er-shubhendu-ee/cryonano-nano-stage/cryonano-nano-stage/outputs/bom/Proposed major components.xlsx

Reference | Qty | Value | Order No. | Indicative Unit Price @10 per lot | Description | Datasheet
PS1 | 1 | B2415S-1WR3 | B2415S-1WR3 | 110 | 1W, constant voltage input, isolated unregulated single output DC-DC power module, efficiency up to 85% | https://www.mornsun-power.com/public/uploads/pdf/B_S-1WR3.pdf
PS2 | 1 | B2405S-1WR3 | B2405S-1WR3 | 75 | 1W, constant voltage input, isolated unregulated single output DC-DC power module, efficiency up to 85% | https://www.mornsun-power.com/public/uploads/pdf/B_S-1WR3.pdf
U1 | 1 | AD7124-8BCPZ-RL7 | AD7124-8BCPZ-RL7 | 1230 | 8-Channel, Low Noise, Low Power, 24-Bit, Sigma-Delta ADC with PGA and Reference | https://www.analog.com/AD7124-8/datasheet
U3 | 1 | 1ED3141MU12FXUMA1 | 1ED3141MU12FXUMA1 | 130 | Galvanically Isolated Gate Drivers | https://www.infineon.com/assets/row/public/documents/24/49/infineon-1ed314xmu12f1ed314xmc12h-datasheet-en.pdf
U4 | 1 | AP7363-33D-13 | AP7363-33D-13 | 27 | LDO Voltage Regulators 1.5A Fast Transient Ultra-LDO Linear Reg | https://www.diodes.com/assets/Datasheets/AP7363.pdf
U5 | 1 | STM32L412CxTx | STM32L412C8T6 | 272 | Arm Cortex-M4 32-bit MCU+FPU, 100DMIPS, up to 128KB flash, 40KB SRAM, analog, USB | https://www.st.com/resource/en/datasheet/stm32l412c8.pdf
