er-shubhendu-ee/cryonano-nano-stage/cryonano-nano-stage/outputs/schematics/cryonano-nano-stage.pdf

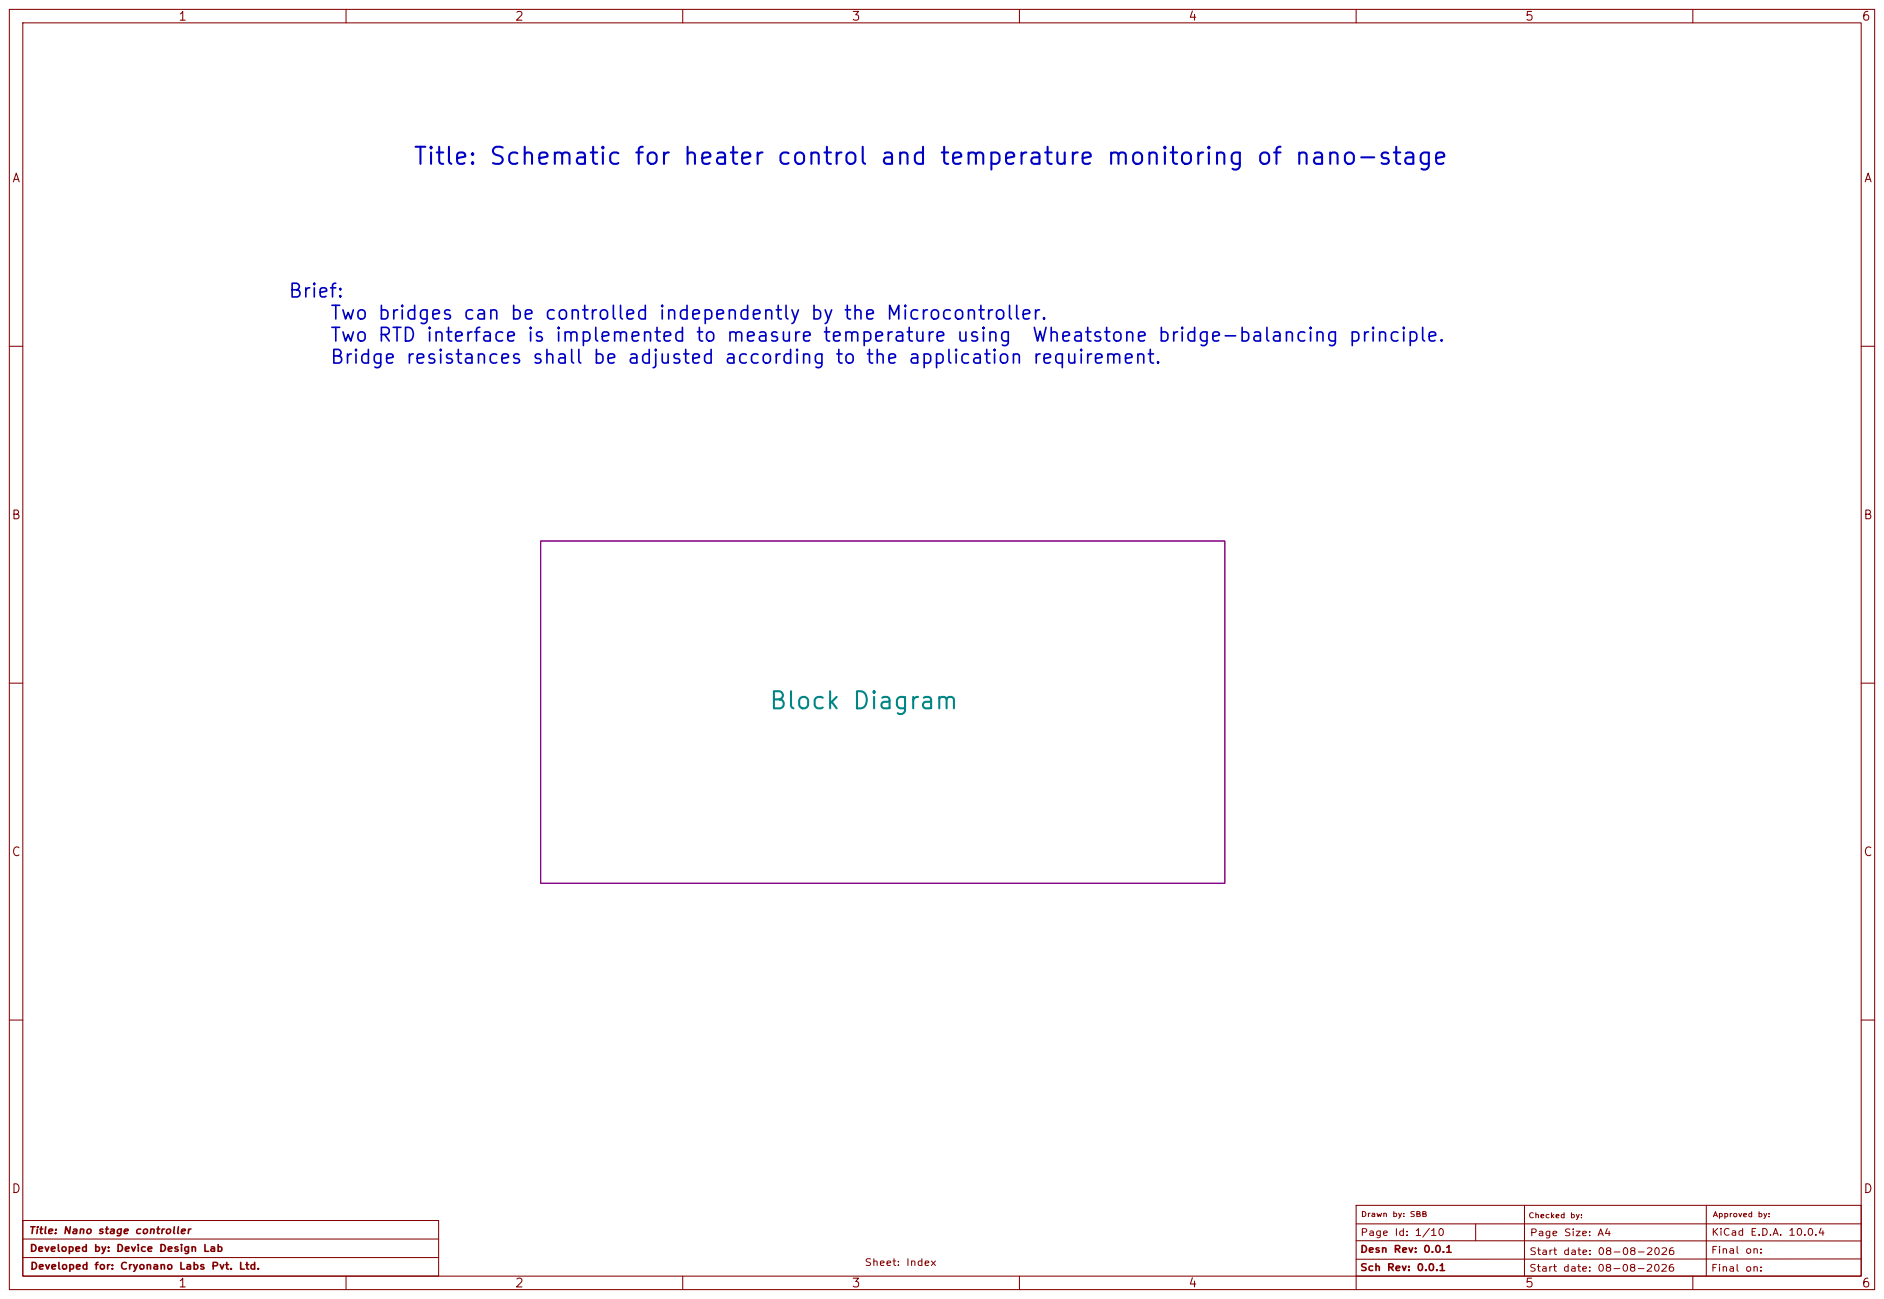
[picture p1: page 1]

Title: Schematic for heater control and temperature monitoring of nano-stage

Brief:
Two bridges can be controlled independently by the Microcontroller.
Two RTD interface is implemented to measure temperature using Wheatstone bridge-balancing principle.
Bridge resistances shall be adjusted according to the application requirement.

Drawn by: SBB Page Id: 1/10
Approved by: KiCad E.D.A. 10.0.4 Desn Rev: 0.0.1

Sch Rev: 0.0.1

Start date: 08-08-2026

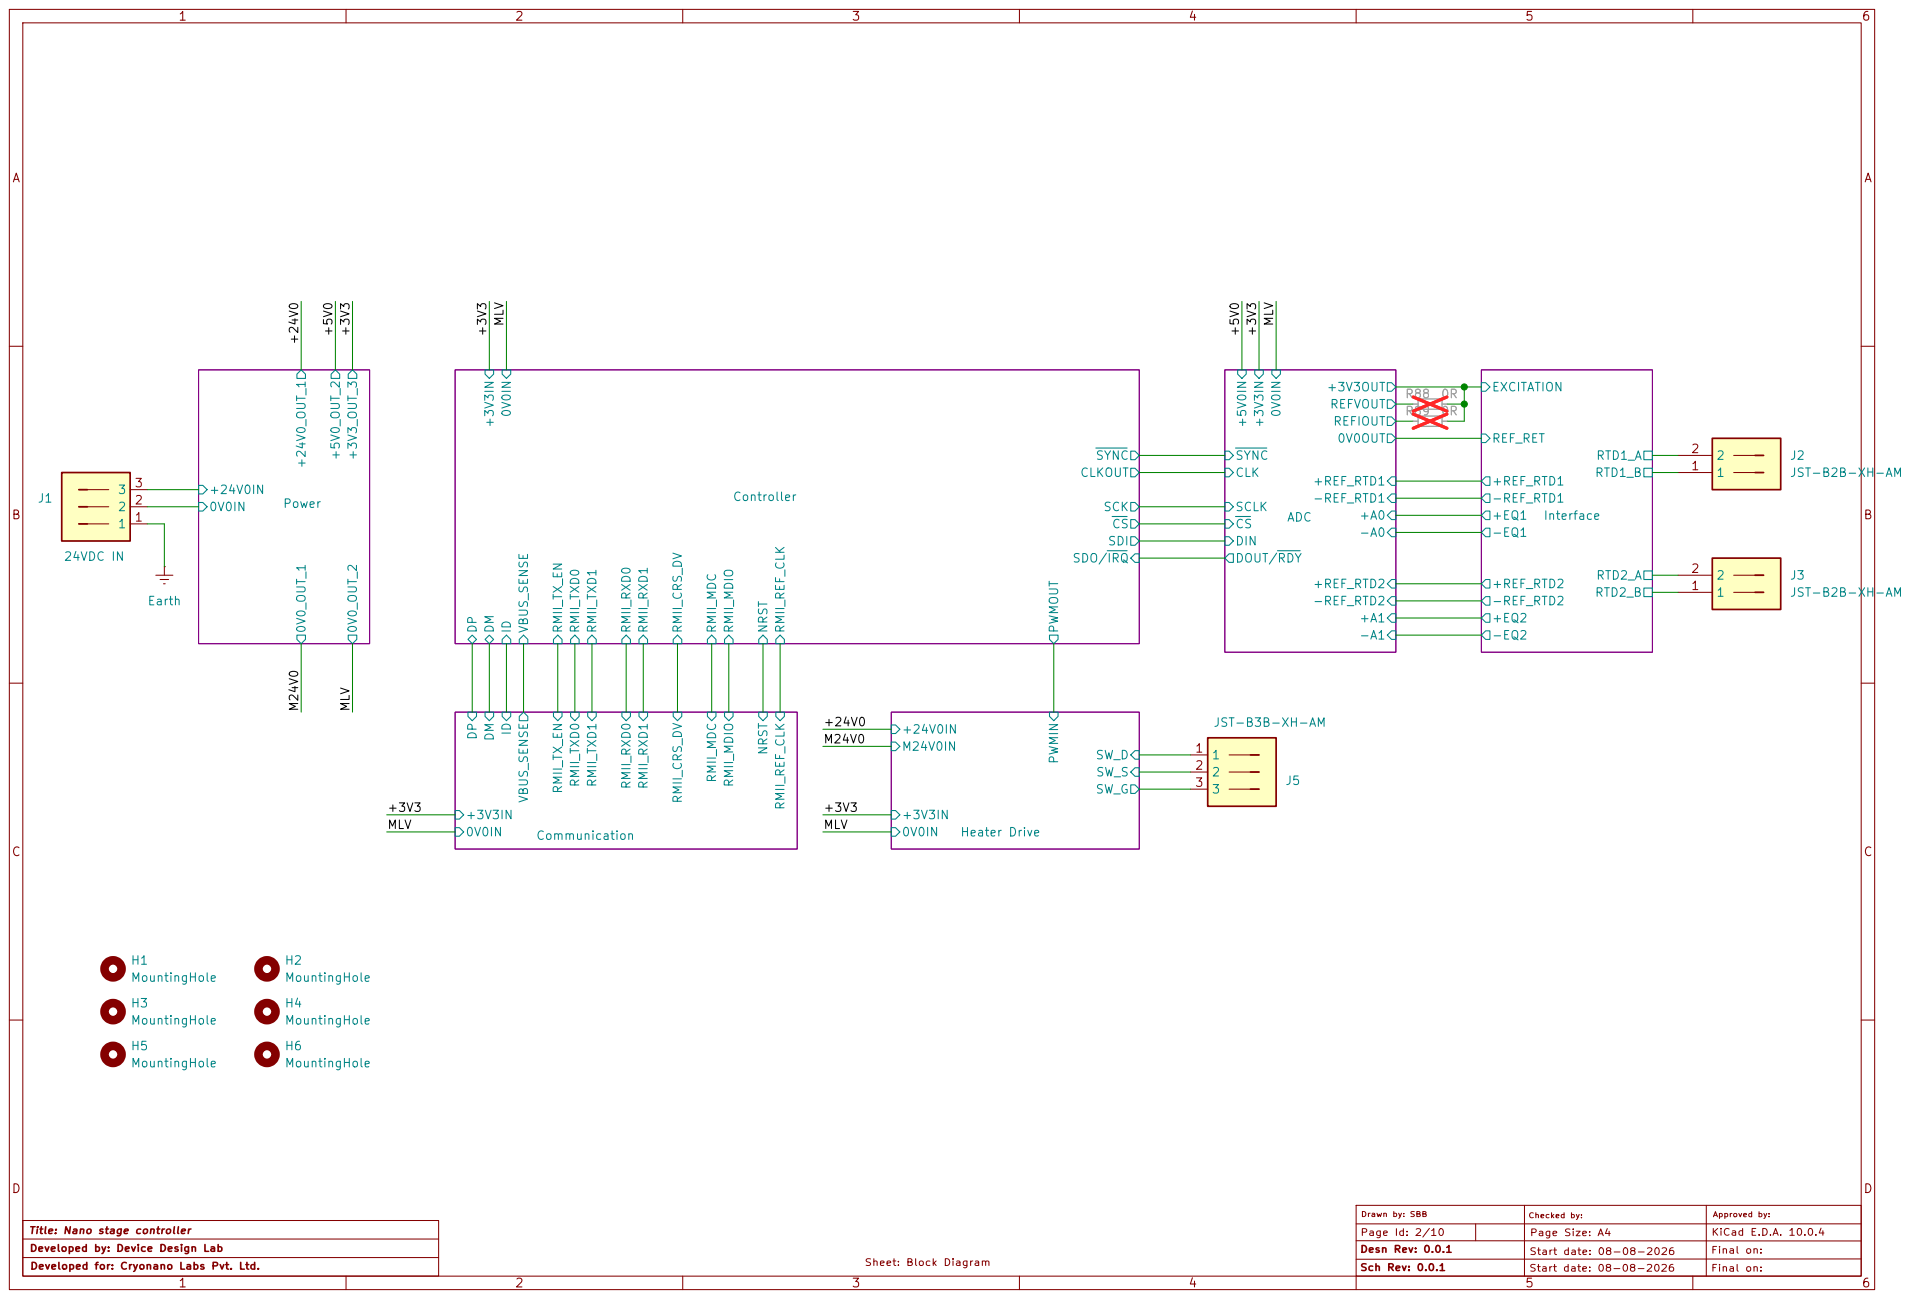
[picture p2: page 2]

Drawn by: SBB Page Id: 2/10
Approved by: KiCad E.D.A. 10.0.4 Desn Rev: 0.0.1

Start date: 08-08-2026 Sheet: Block Diagram

Final on:

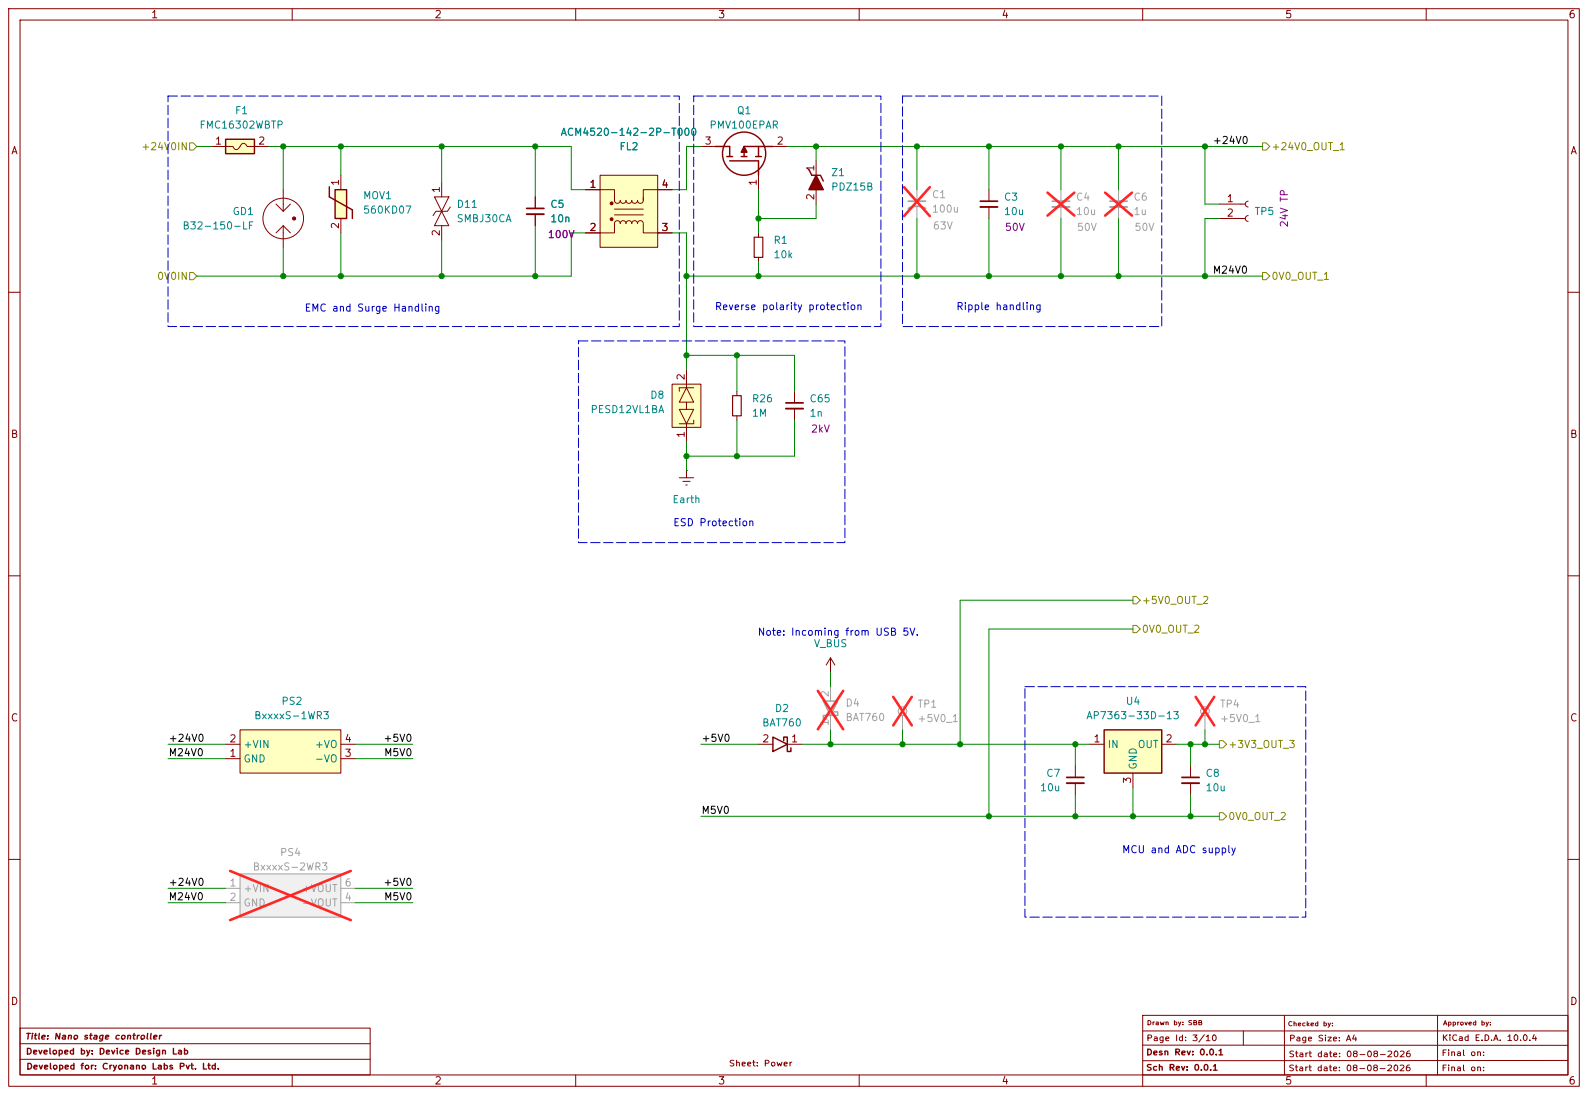
[picture p3: page 3]

Checked by: Developed for: Cryonano Labs Pvt. Ltd.

Drawn by: SBB Page Id: 3/10
Approved by: KiCad E.D.A. 10.0.4 Desn Rev: 0.0.1

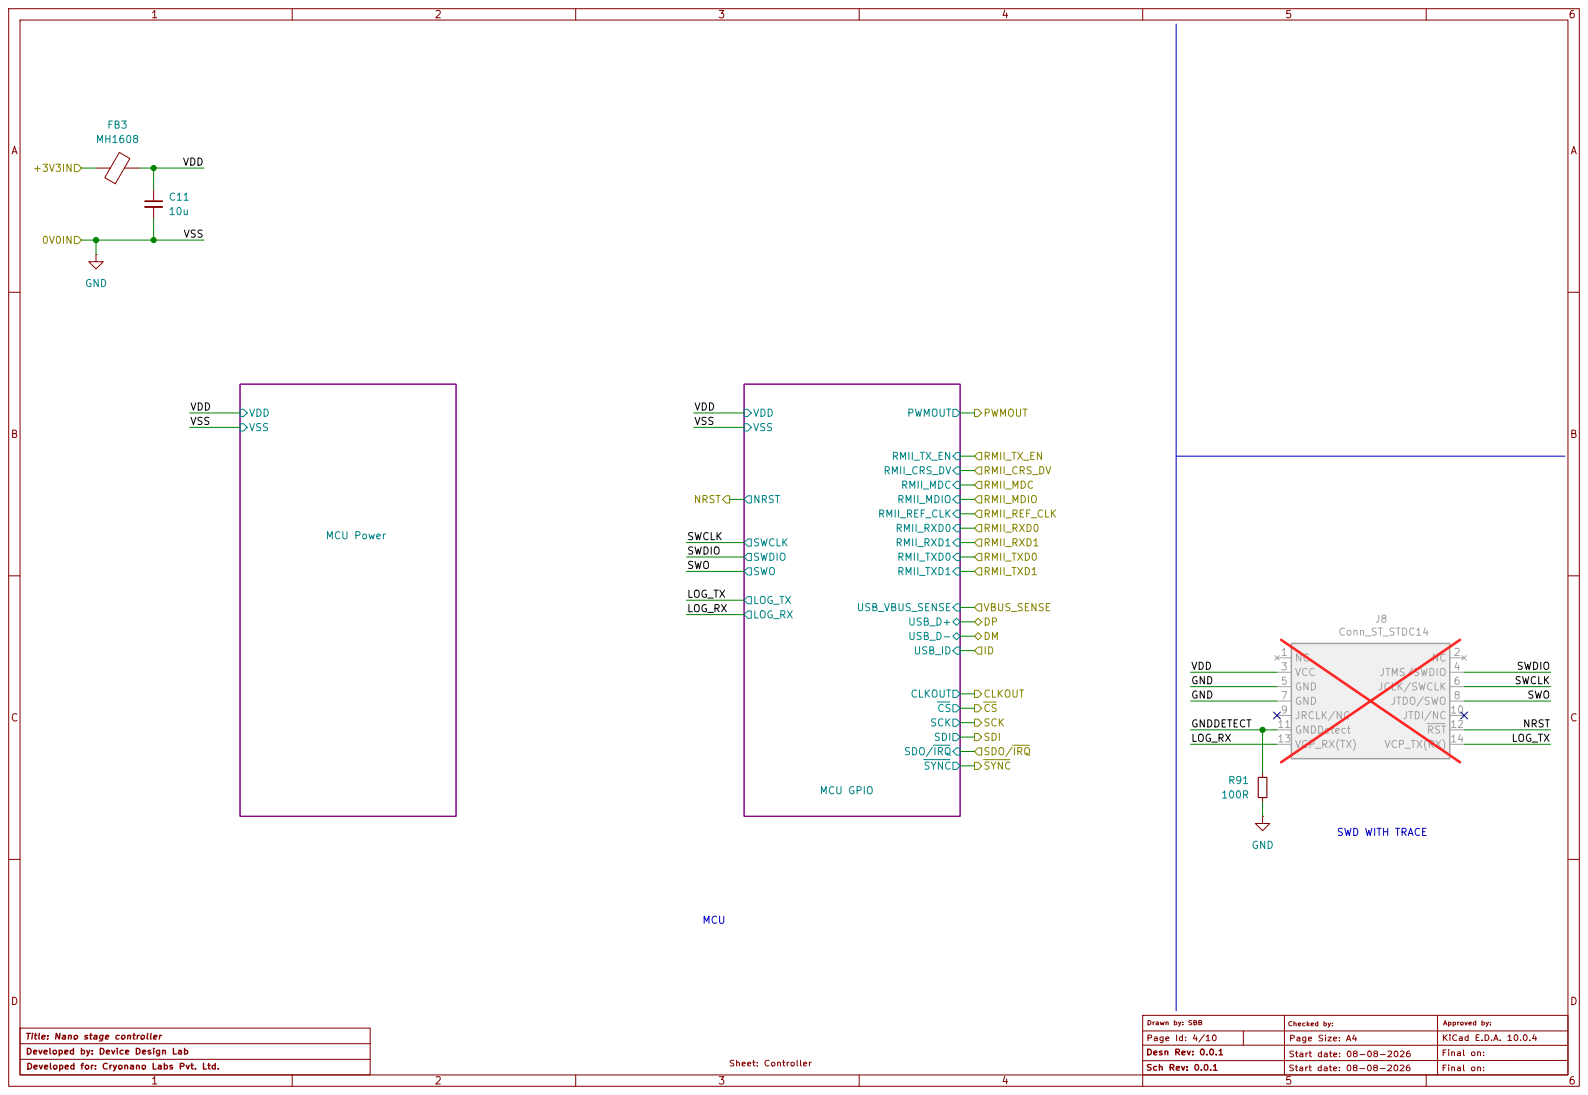
[picture p4: page 4]

Checked by: Developed for: Cryonano Labs Pvt. Ltd.

Drawn by: SBB Page Id: 4/10
Approved by: KiCad E.D.A. 10.0.4 Desn Rev: 0.0.1

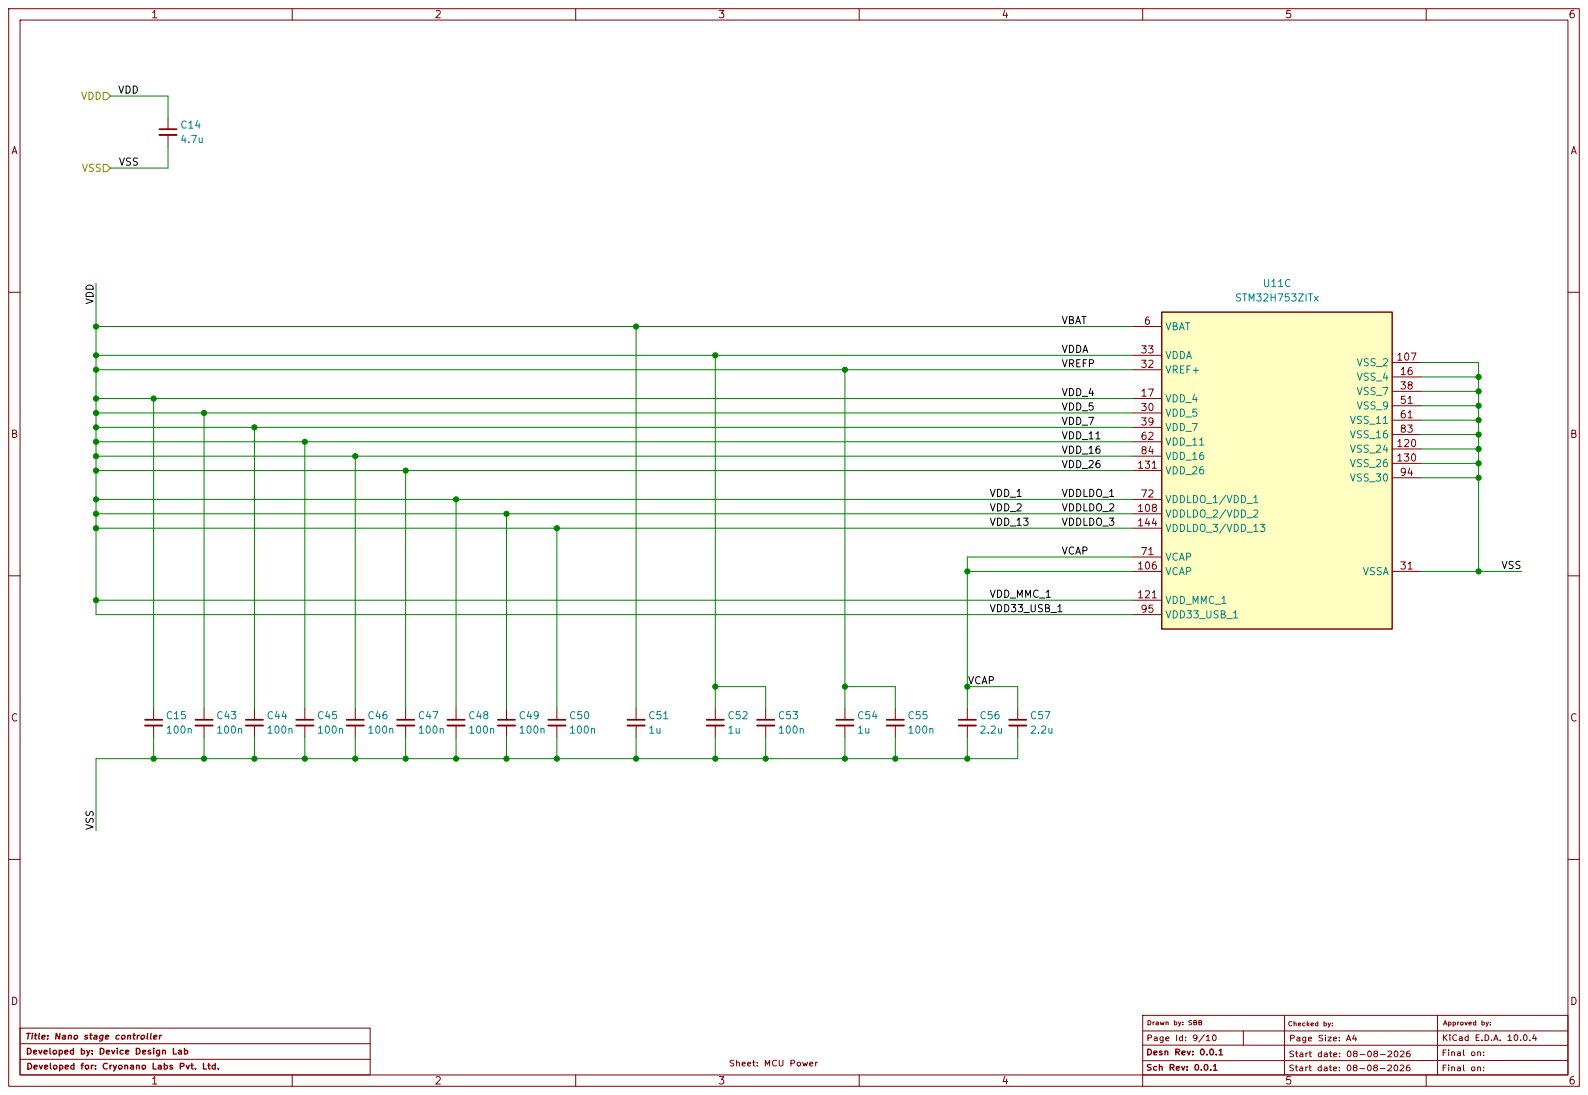
[picture p5: page 5]

VSS VDD VSS | VDD_4 | VDD_4 17

VDD_11 | STM32H753ZITx C54 VDD_11 62

VDD_5 | VDD_5 30
VDD_7 | VDD_7 39

VDD_16 | VDD_16 84
VDD_26 | VDD_26 131

VDD_1 VDDLDO_1 | VDDLDO_1/VDD_1 72
VDD_2 VDDLDO_2 | VDDLDO_2/VDD_2 108
VDD_13 VDDLDO_3

VCAP | VCAP 71

Checked by: Developed for: Cryonano Labs Pvt. Ltd.

Drawn by: SBB Page Id: 9/10
Approved by: KiCad E.D.A. 10.0.4 Desn Rev: 0.0.1

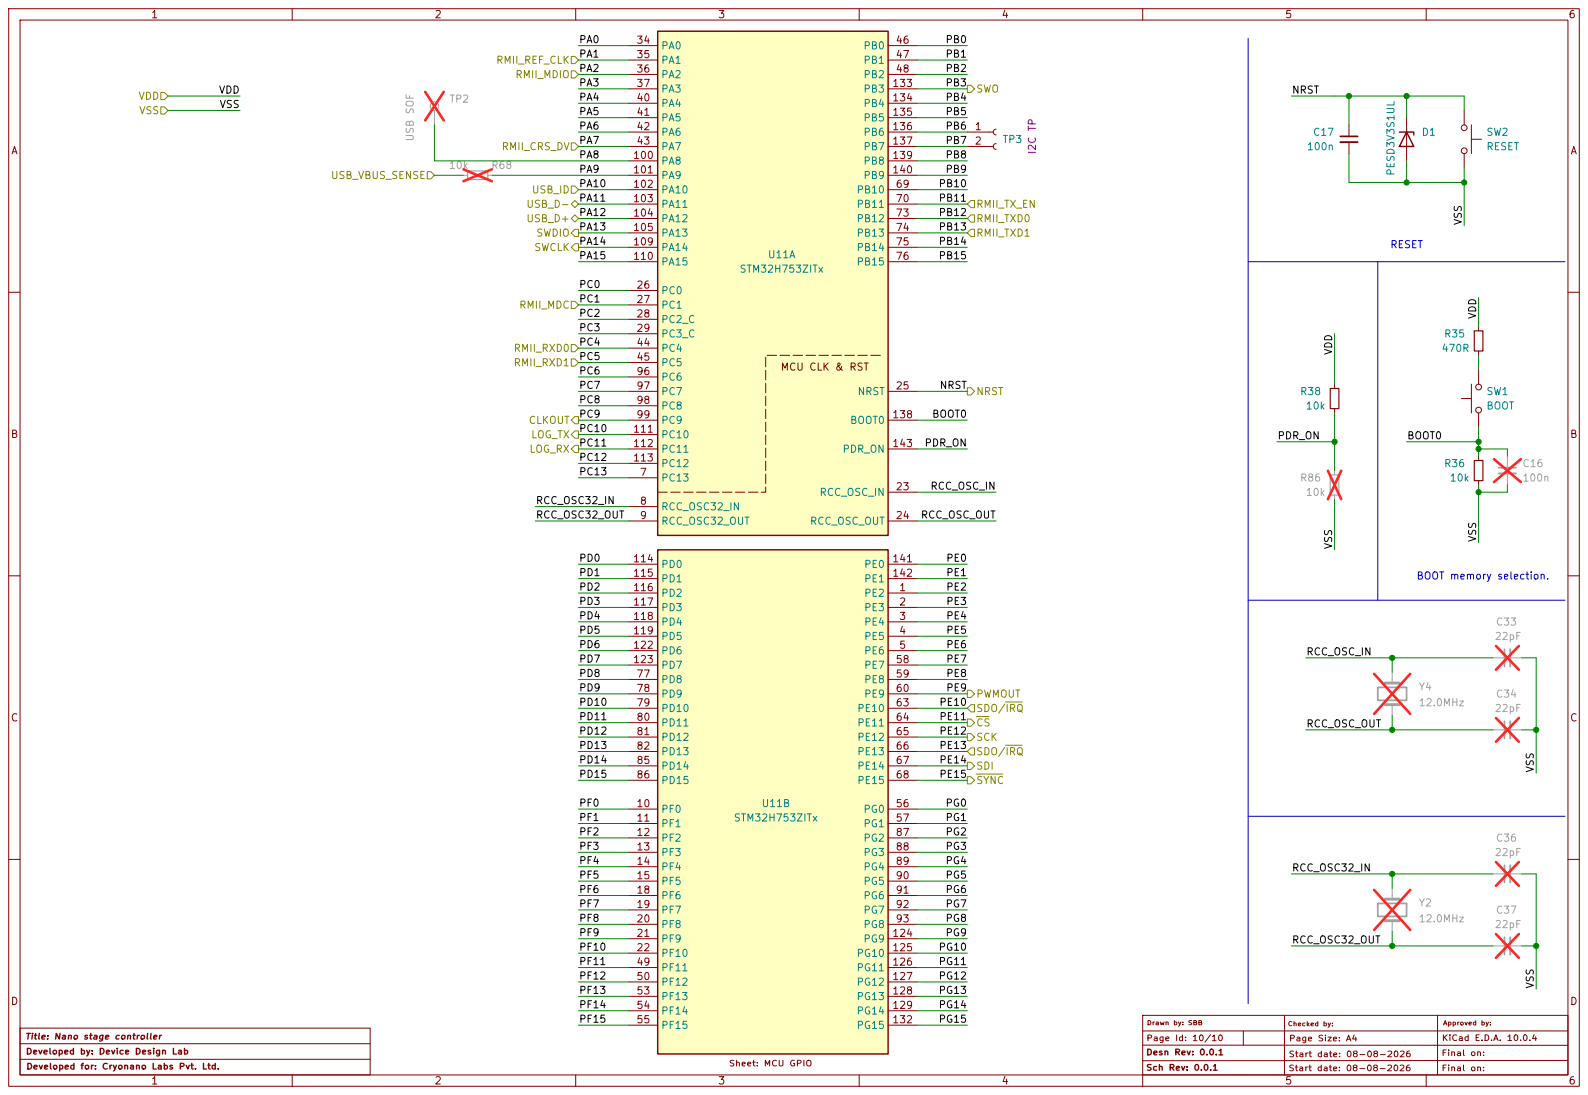
[picture p6: page 6]

Checked by: Developed for: Cryonano Labs Pvt. Ltd.

Drawn by: SBB Page Id: 10/10
Approved by: KiCad E.D.A. 10.0.4 Desn Rev: 0.0.1

Start date: 08-08-2026 Sheet: MCU GPIO

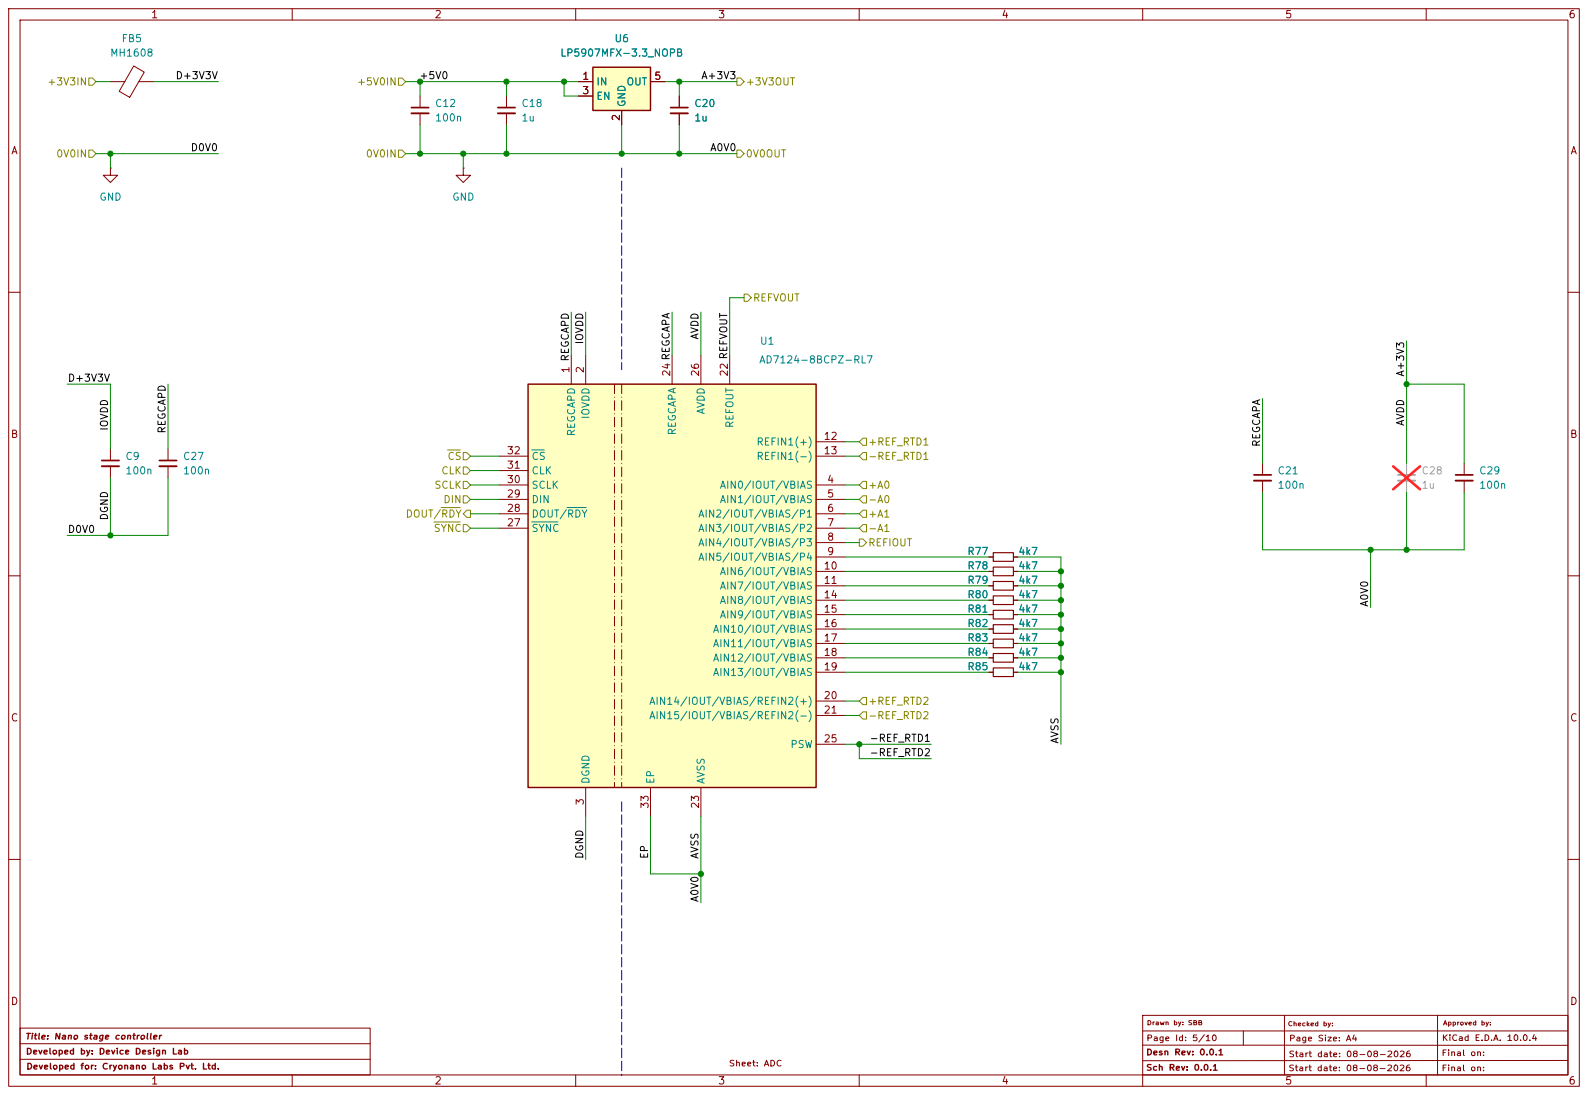
[picture p7: page 7]

Checked by: Developed for: Cryonano Labs Pvt. Ltd.

Drawn by: SBB Page Id: 5/10
Approved by: KiCad E.D.A. 10.0.4 Desn Rev: 0.0.1

Start date: 08-08-2026 Sheet: ADC

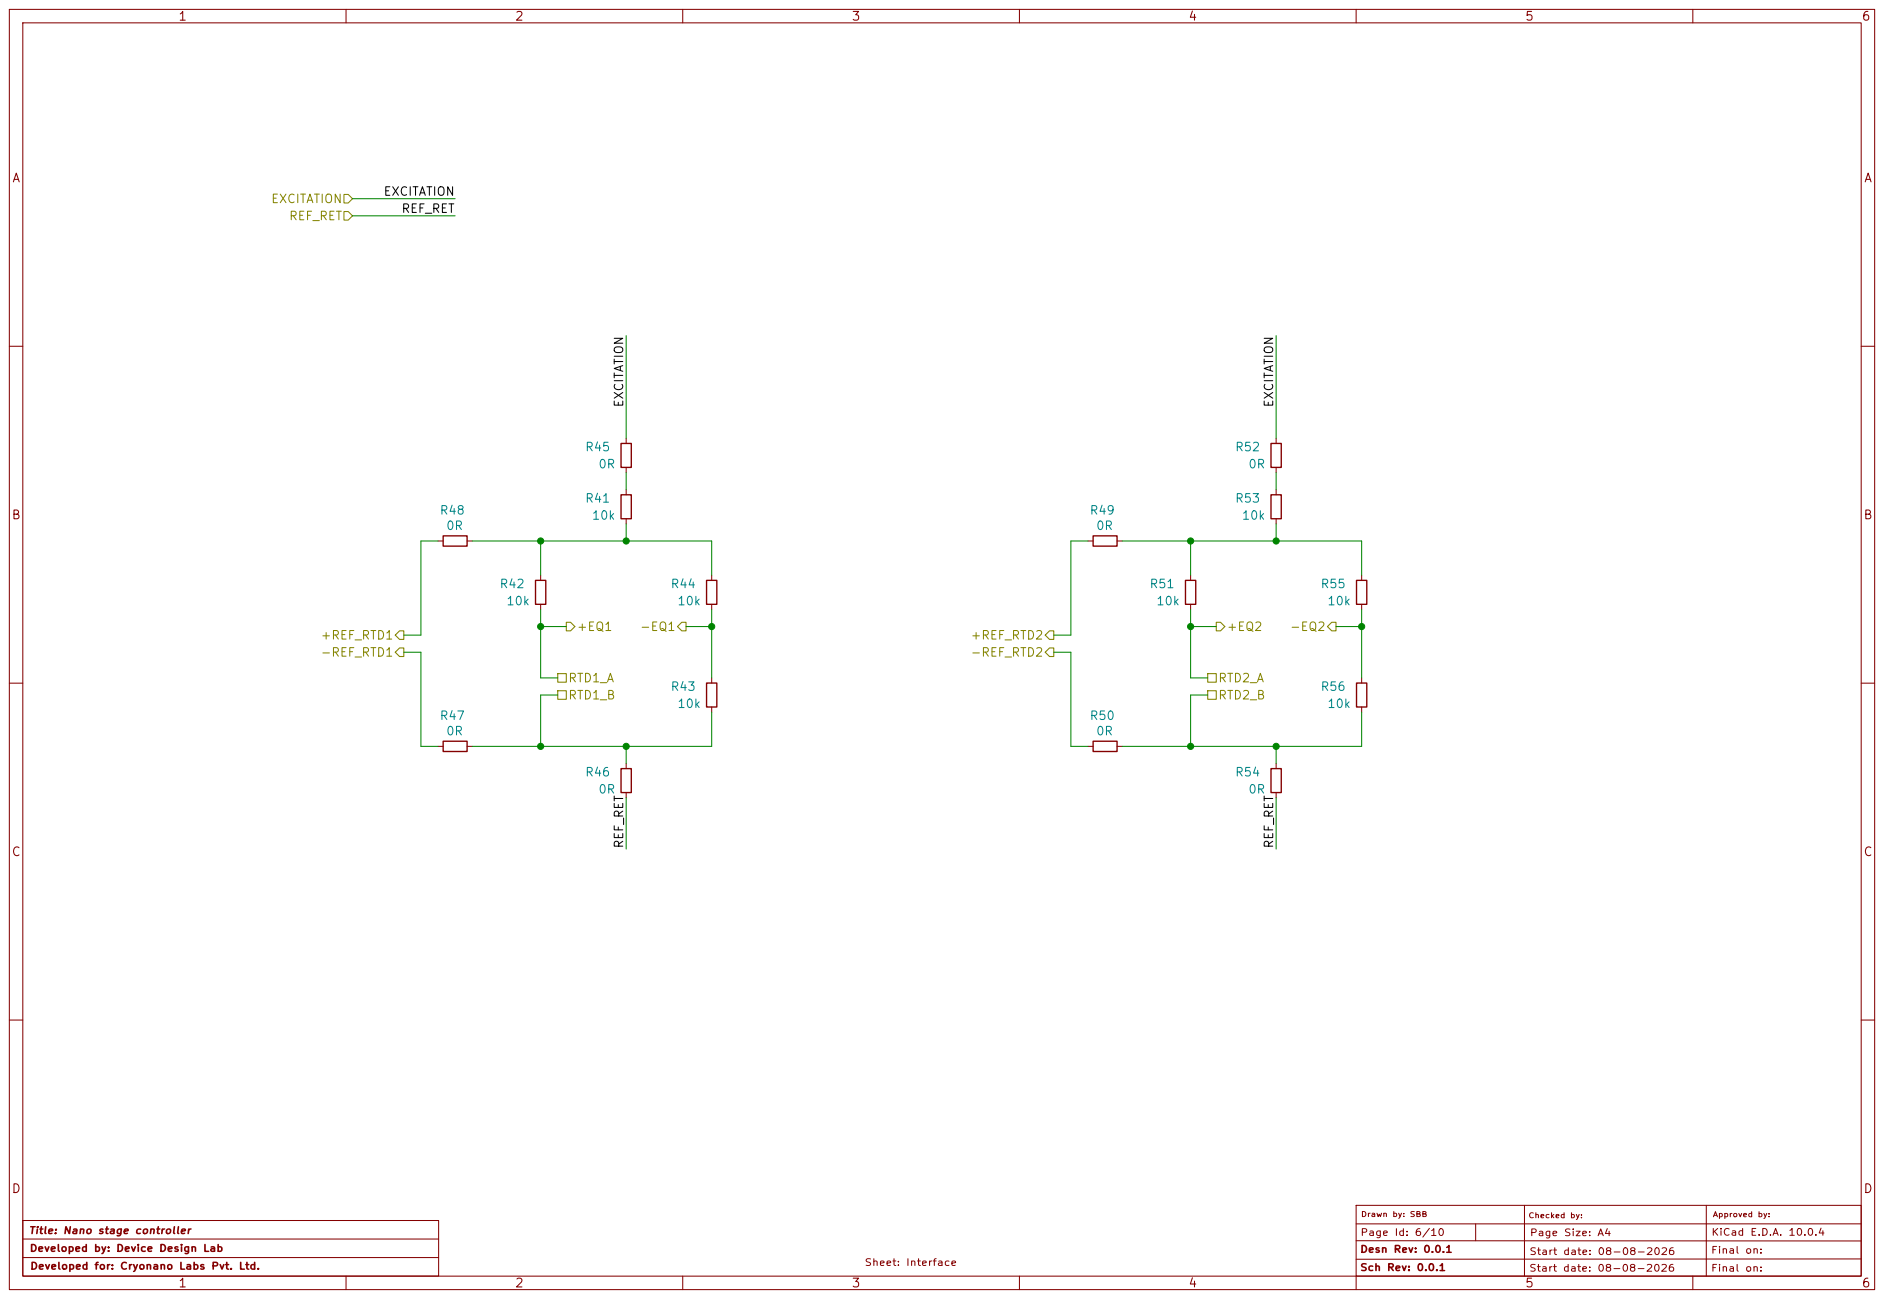
[picture p8: page 8]

Checked by: Developed for: Cryonano Labs Pvt. Ltd.

Drawn by: SBB Page Id: 6/10
Approved by: KiCad E.D.A. 10.0.4 Desn Rev: 0.0.1

Start date: 08-08-2026 Sheet: Interface

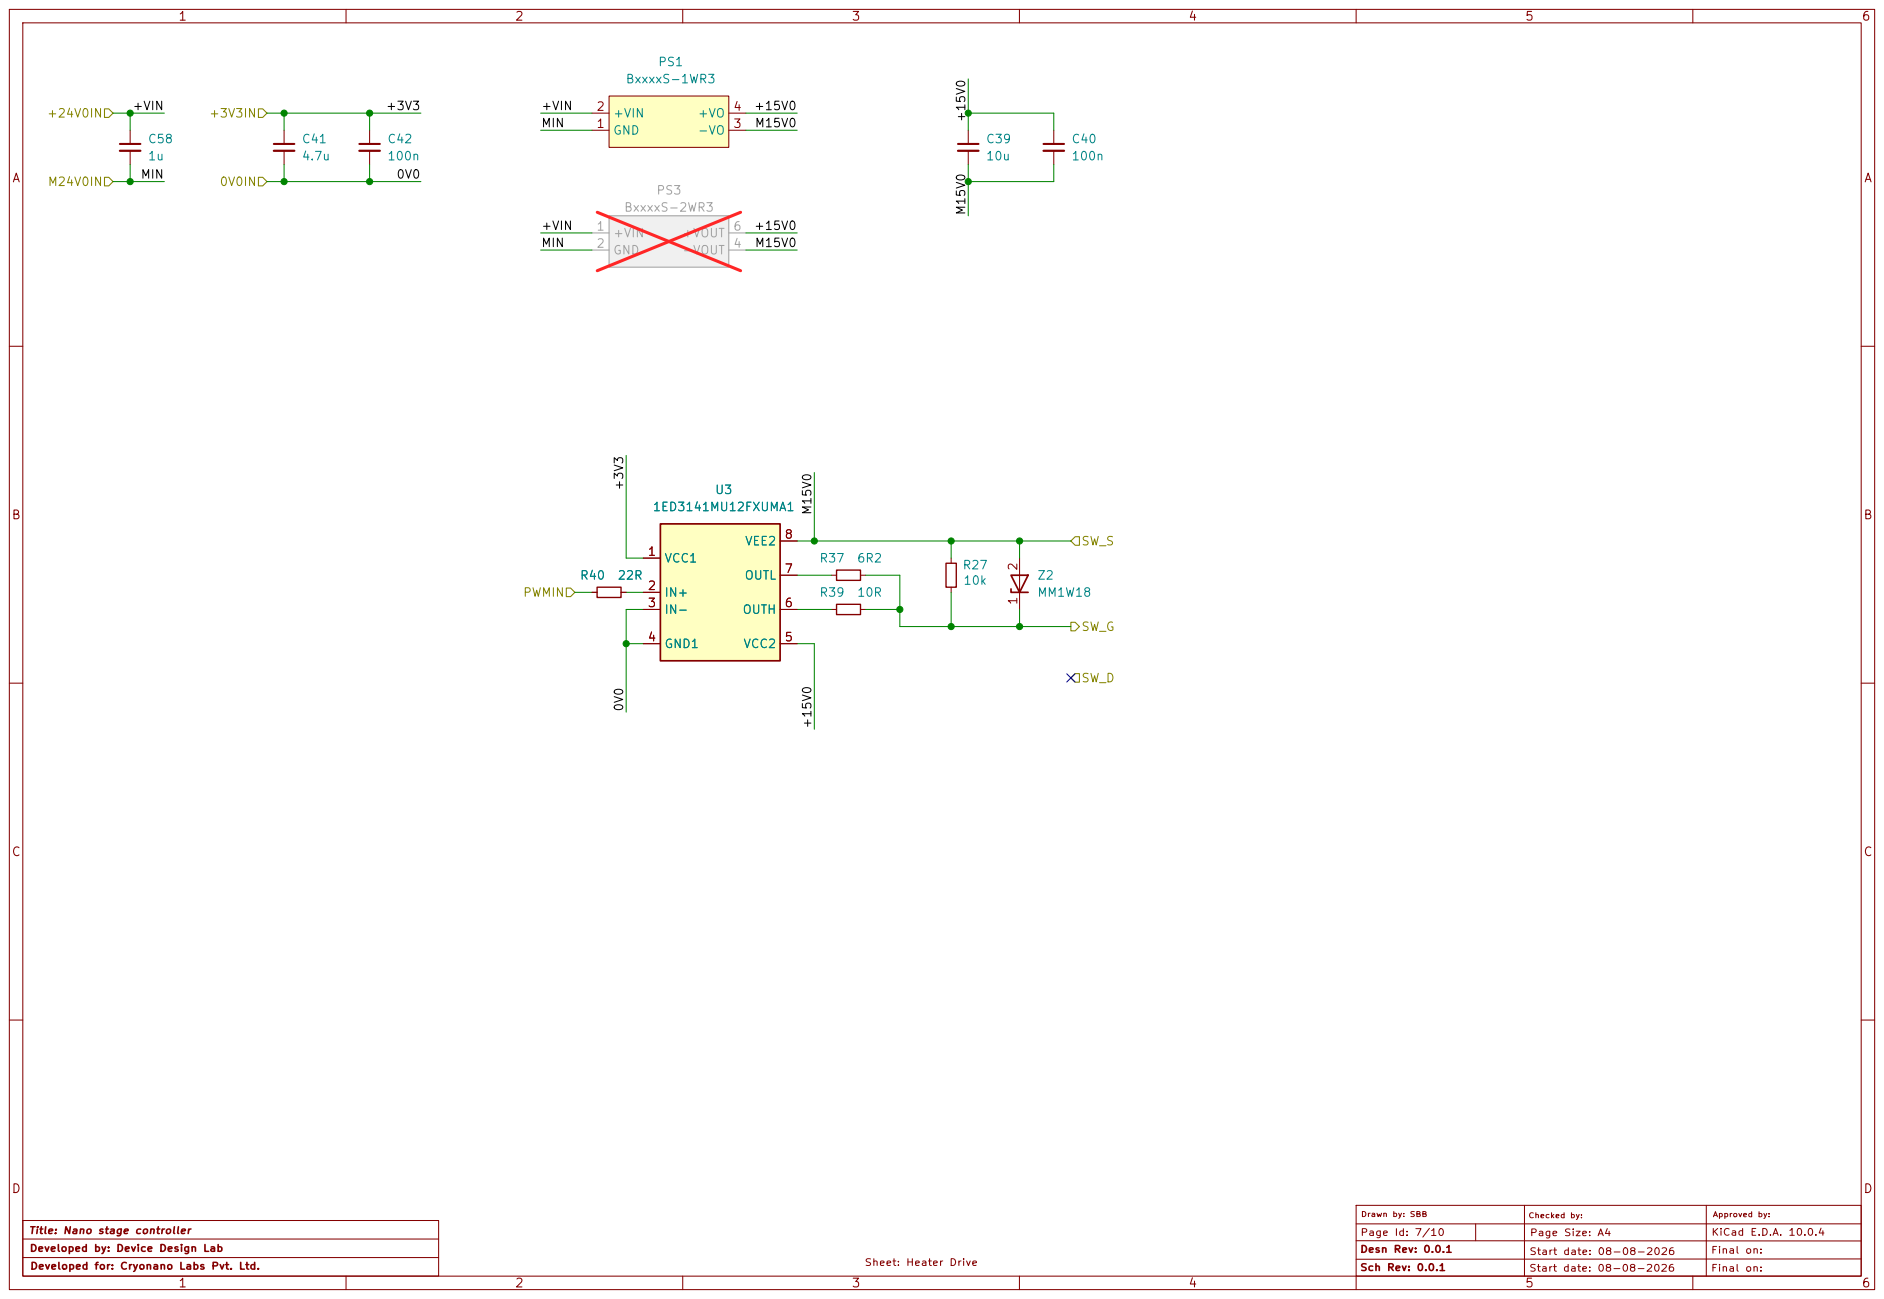
[picture p9: page 9]

Checked by: Developed for: Cryonano Labs Pvt. Ltd.

Drawn by: SBB Page Id: 7/10
Approved by: KiCad E.D.A. 10.0.4 Desn Rev: 0.0.1

Start date: 08-08-2026 Sheet: Heater Drive

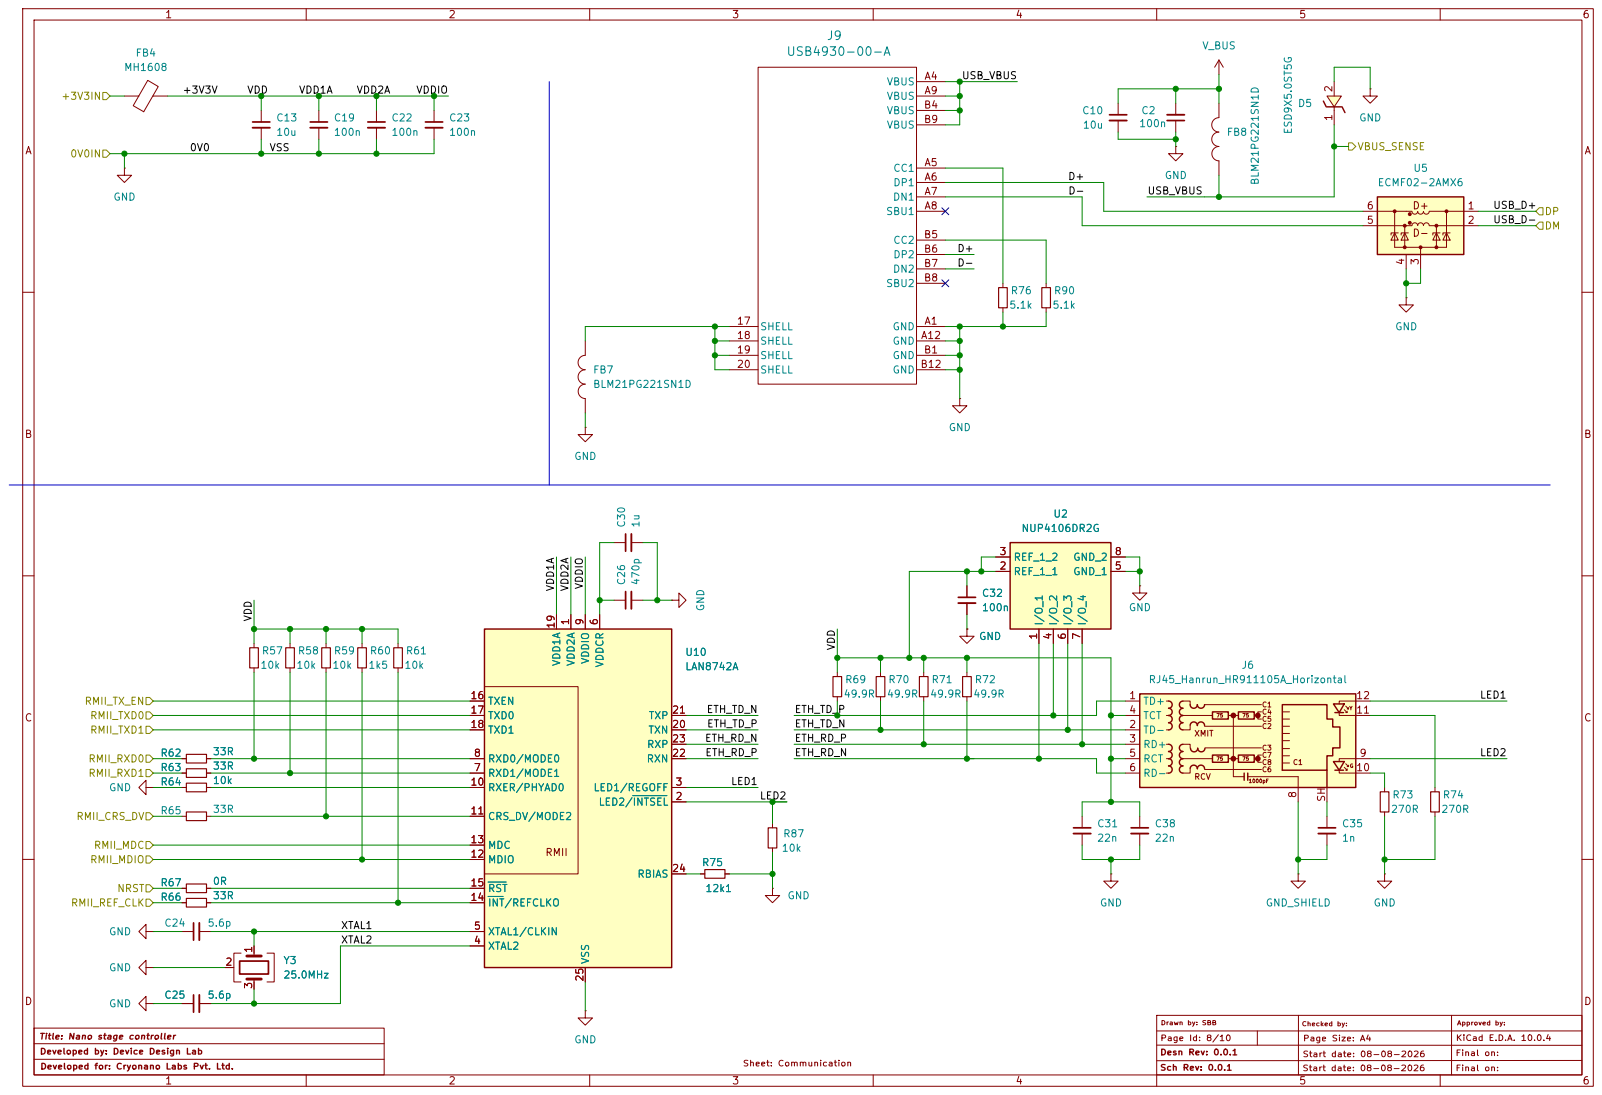
[picture p10: page 10]

Drawn by: SBB Page Id: 8/10
Approved by: KiCad E.D.A. 10.0.4 Desn Rev: 0.0.1

Start date: 08-08-2026 Sheet: Communication
