er-shubhendu-ee/cryonano-nano-stage/cryonano-nano-stage/cryonano-nano-stage.kicad_pcb

## KiCad design cryonano-nano-stage/cryonano-nano-stage.kicad_pcb (2026-08-27)

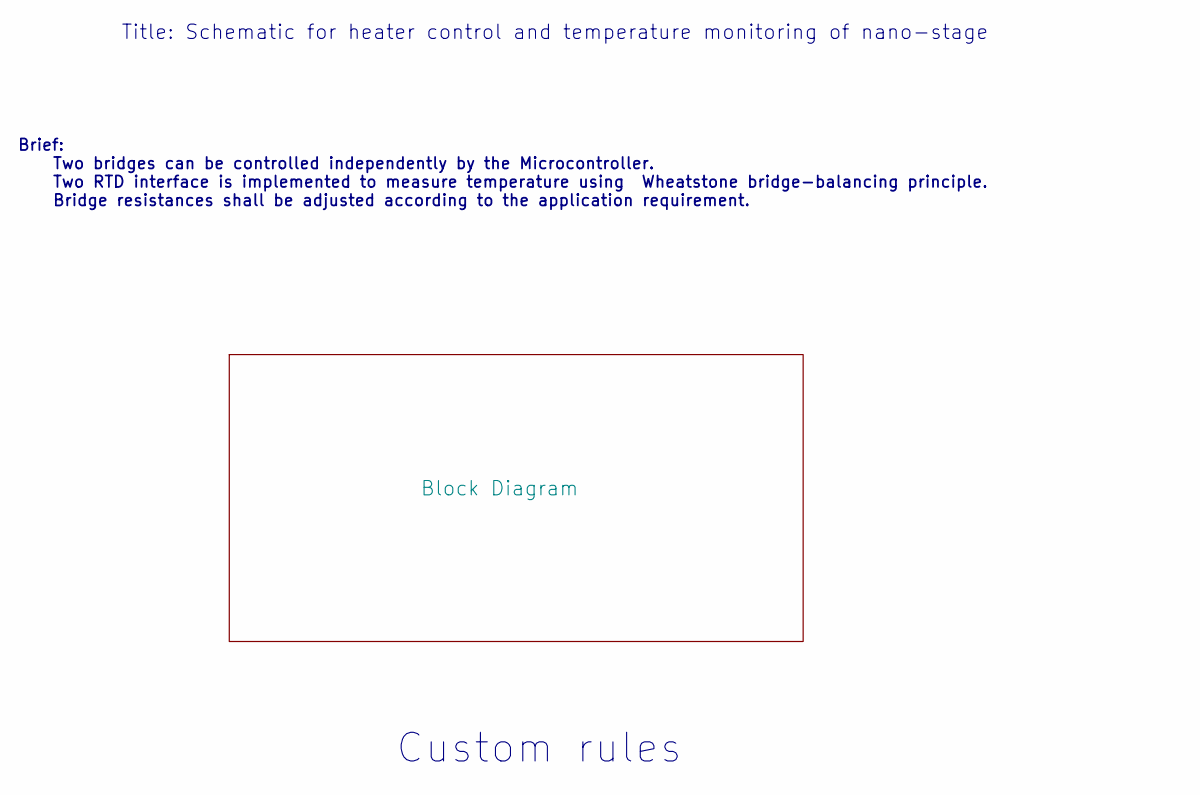
[picture p11: schematic cryonano-nano-stage.kicad_sch, Nano stage controller]

Notes on the sheet:
Brief: Two bridges can be controlled independently by the Microcontroller. Two RTD interface is implemented to measure temperature using Wheatstone bridge-balancing principle. Bridge resistances shall be adjusted according to the application requirement.
Custom rules
Title: Schematic for heater control and temperature monitoring of nano-stage

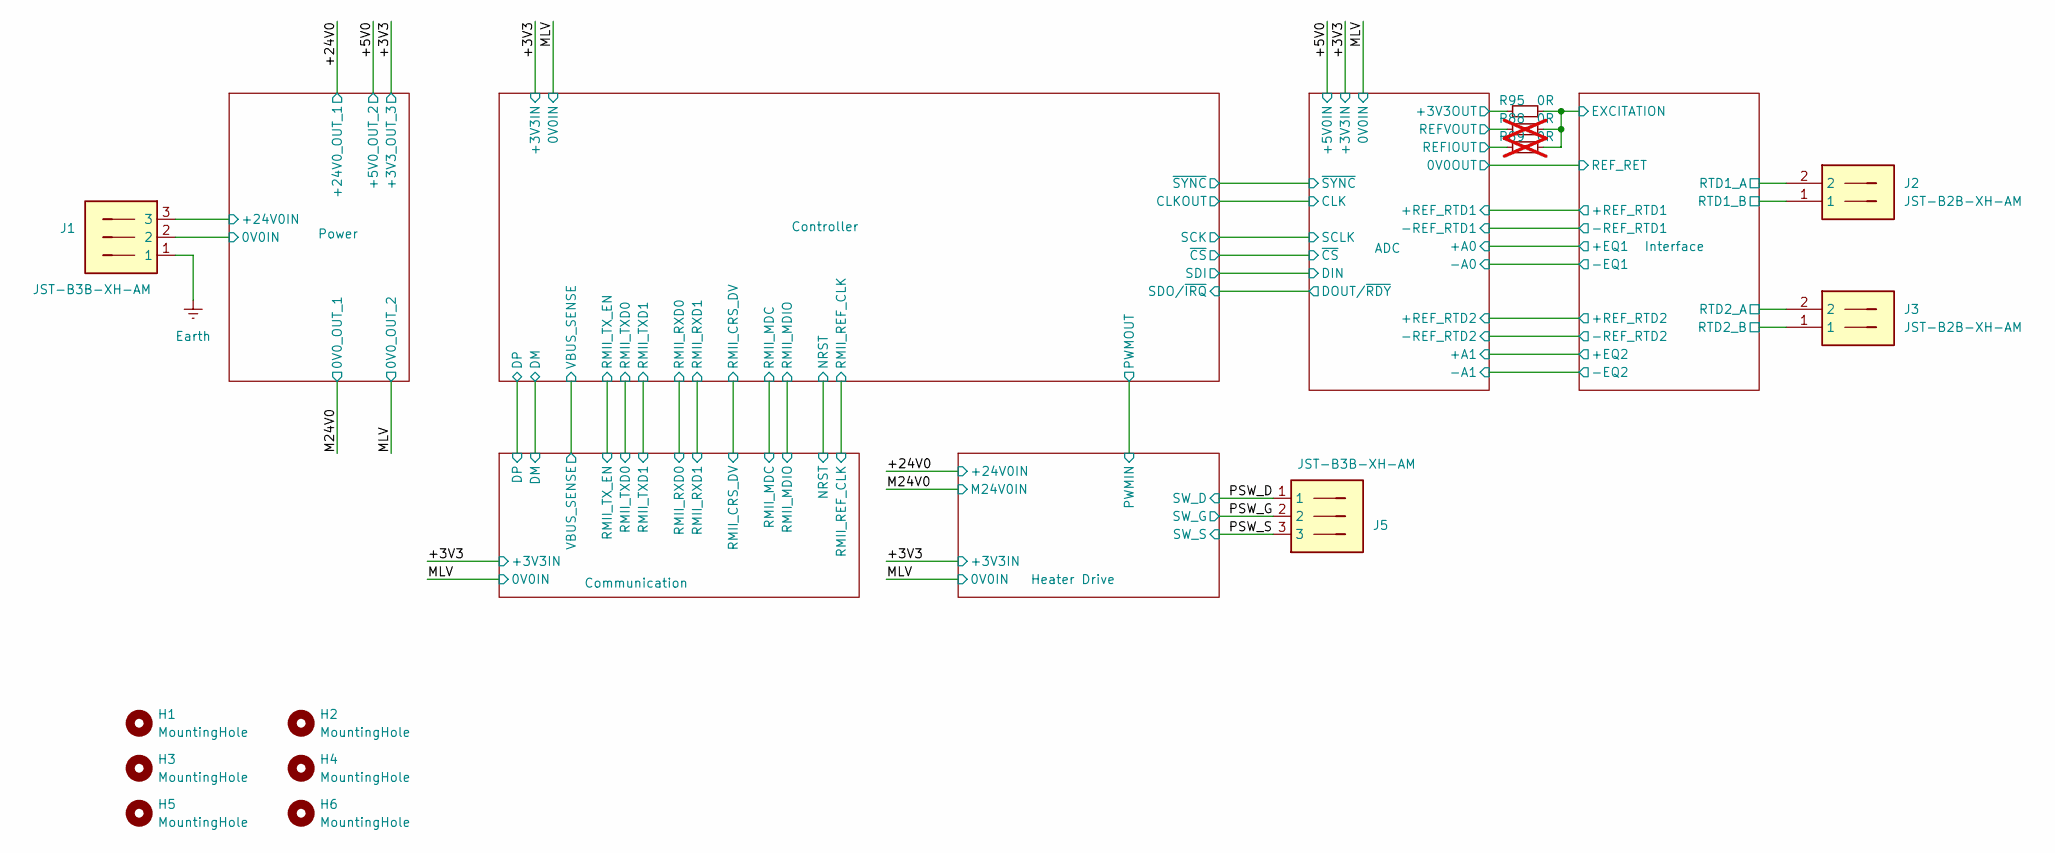
[picture p12: schematic block-diagram.kicad_sch, Nano stage controller]

Parts:
H1, H2, H3, H4, H5, H6: MountingHole; MountingHole_3.7mm_Pad_Small
J1, J5: JST-B3B-XH-AM; B3BXHAMLFSN
J2, J3: JST-B2B-XH-AM; B2BXHAMLFSN
R88, R89: 0R; R_0805_2012Metric_Pad1.20x1.40mm_HandSolder; not fitted
R95: 0R; R_0805_2012Metric_Pad1.20x1.40mm_HandSolder

Connections:
/Block Diagram/ADC/+A0: J2.2; also elsewhere on the board
/Block Diagram/ADC/+A1: J3.2; also elsewhere on the board
/Block Diagram/ADC/A+3V3: R95.2; also elsewhere on the board
/Block Diagram/ADC/REFIOUT: R89.2; also elsewhere on the board
/Block Diagram/ADC/REFVOUT: R88.2; also elsewhere on the board
/Block Diagram/Interface/EXCITATION: R88.1, R89.1, R95.1; also elsewhere on the board
/Block Diagram/Interface/RTD1_B: J2.1; also elsewhere on the board
/Block Diagram/Interface/RTD2_B: J3.1; also elsewhere on the board
/Block Diagram/PSW_D: J5.1; also elsewhere on the board
/Block Diagram/PSW_G: J5.2; also elsewhere on the board
/Block Diagram/PSW_S: J5.3; also elsewhere on the board
/Block Diagram/Power/0V0IN: J1.2; also elsewhere on the board
/Block Diagram/Power/+24V0IN: J1.3; also elsewhere on the board
Earth: J1.1; also elsewhere on the board

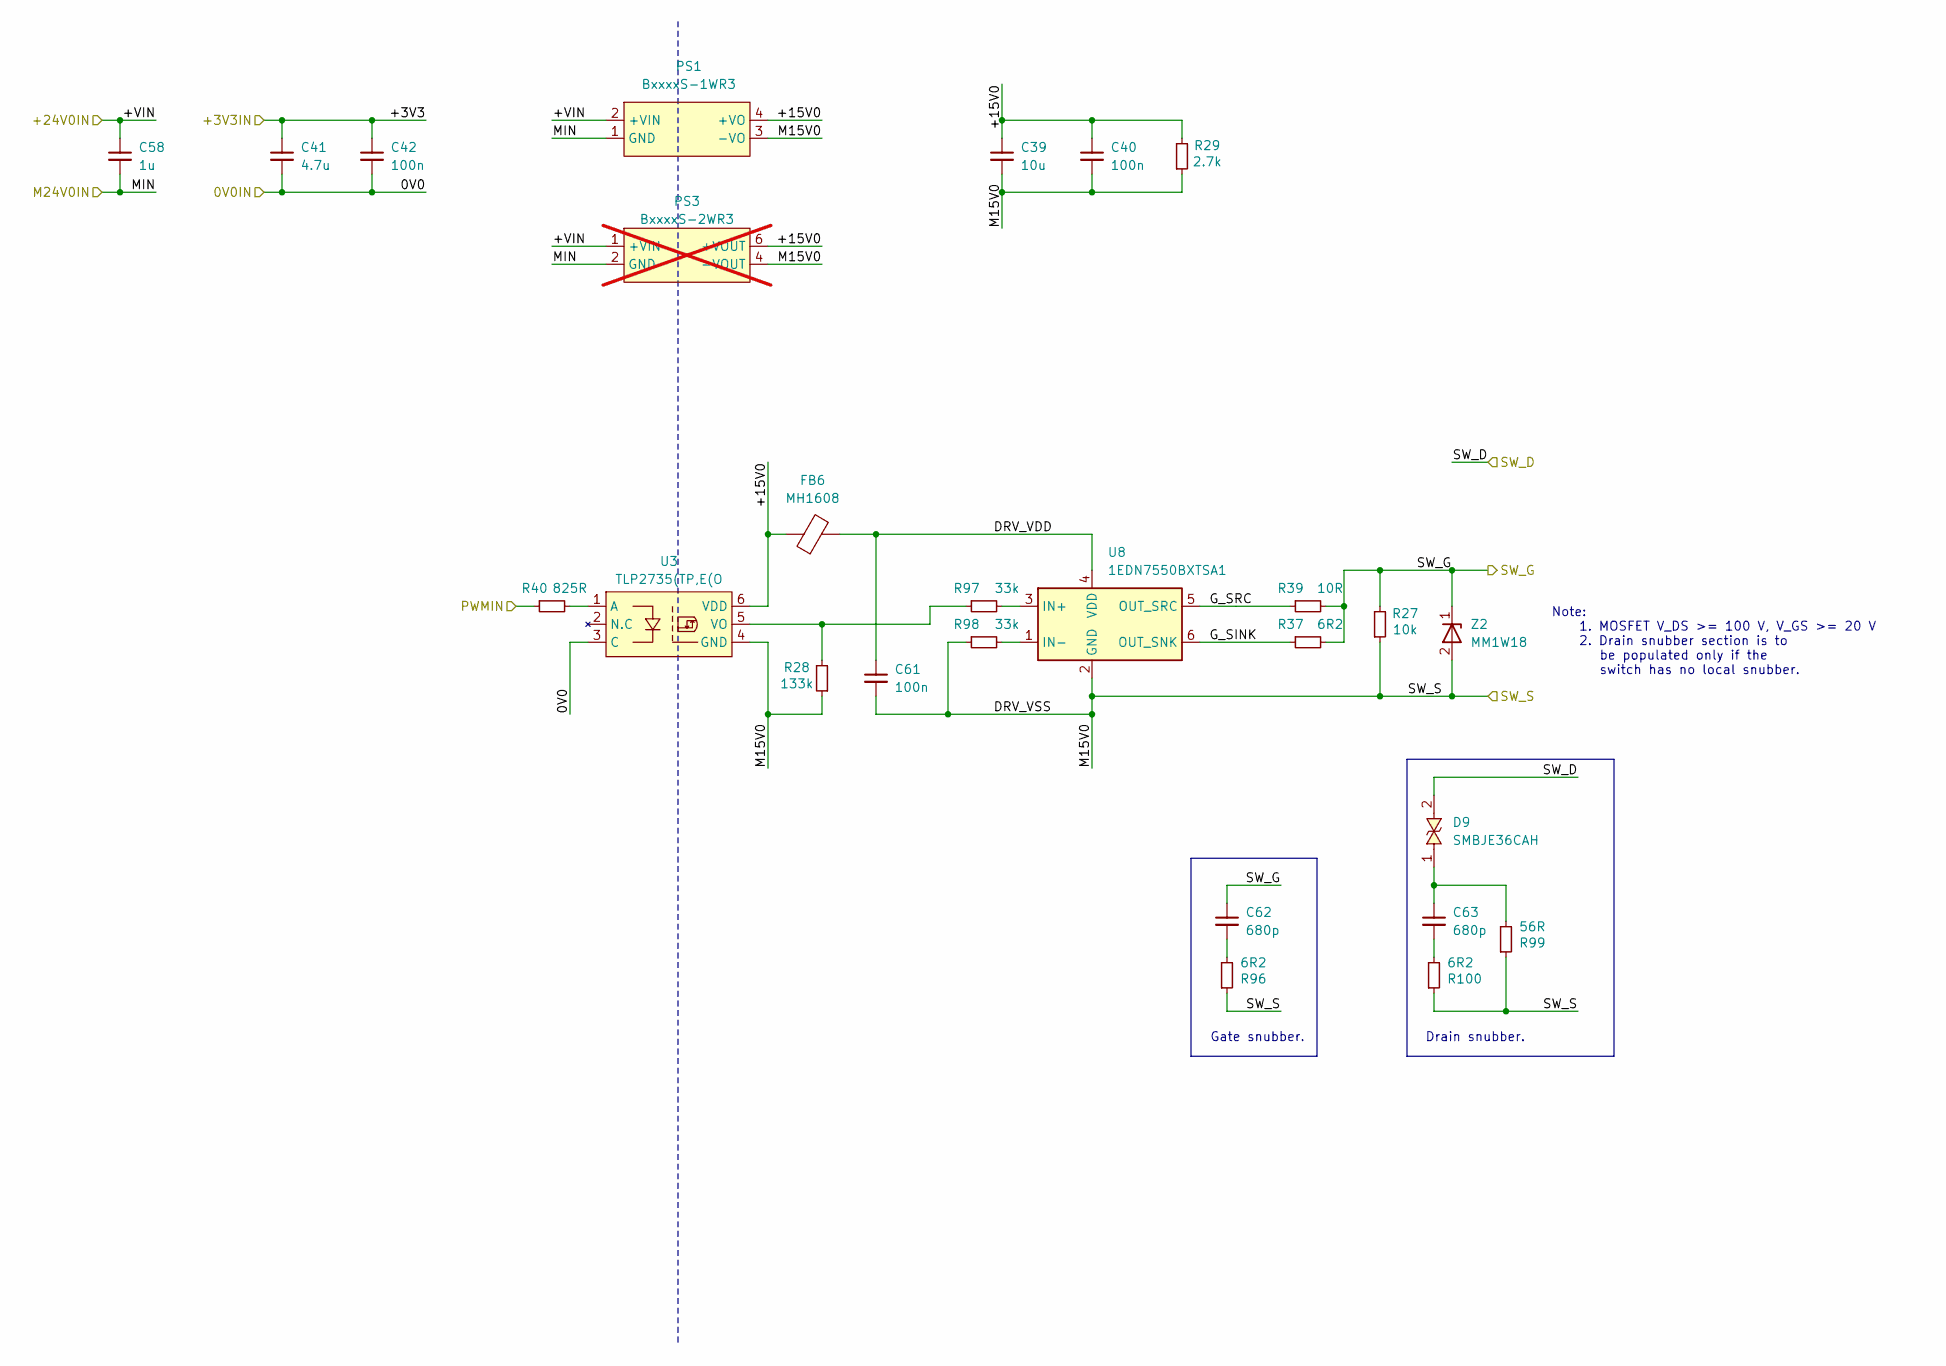
[picture p13: schematic heater-controller.kicad_sch, Nano stage controller]

Parts:
C39: 10u; C_0805_2012Metric; Voltage 50V
C40: 100n; C_0603_1608Metric; Voltage 50V; Tolerence 10%
C41: 4.7u; C_0805_2012Metric; Voltage 16V
C42, C61: 100n; C_0603_1608Metric; Voltage 16V
C58: 1u; C_0805_2012Metric; Voltage 50V
C62, C63: 680p; C_0603_1608Metric; Voltage 50V
D9: SMBJE36CAH; D_SMB
FB6: MH1608; L_0603_1608Metric
PS1: BxxxxS-1WR3
PS3: BxxxxS-2WR3; not fitted
R27: 10k; R_0603_1608Metric
R28: 133k; R_0603_1608Metric
R29: 2.7k; R_0805_2012Metric
R37, R96: 6R2; R_0603_1608Metric
R39: 10R; R_0603_1608Metric
R40: 825R; R_0603_1608Metric
R97, R98: 33k; R_0603_1608Metric
R99: 56R; R_2010_5025Metric
R100: 6R2; R_2010_5025Metric
U3: TLP2735(TP,E(O; SO-6L_10x3.84mm_P1.27mm
U8: 1EDN7550BXTSA1; SOT95P280X145-6N
Z2: MM1W18; D_SOD-123

Connections:
/Block Diagram/+3V3: C41.1, C42.1; also elsewhere on the board
/Block Diagram/+24V0: C58.1, PS1.2 (+VIN), PS3.1 (+VIN); also elsewhere on the board
/Block Diagram/Controller/PWMOUT: R40.1; also elsewhere on the board
/Block Diagram/Heater Drive/+15V0: C39.1, C40.1, FB6.1, PS1.4 (+VO), PS3.6 (+VOUT), R29.2, U3.6 (VDD)
/Block Diagram/Heater Drive/DRV_VDD: C61.1, FB6.2, U8.4 (VDD)
/Block Diagram/Heater Drive/G_SINK: R37.1, U8.6 (OUT_SNK)
/Block Diagram/Heater Drive/G_SRC: R39.1, U8.5 (OUT_SRC)
/Block Diagram/M24V0: C58.2, PS1.1 (GND), PS3.2 (GND); also elsewhere on the board
/Block Diagram/PSW_D: D9.2; also elsewhere on the board
/Block Diagram/PSW_G: C62.1, R27.2, R37.2, R39.2, Z2.1 (C); also elsewhere on the board
/Block Diagram/PSW_S: C39.2, C40.2, C61.2, PS1.3 (-VO), PS3.4 (-VOUT), R27.1, R28.1, R29.1, R96.1, R98.1, R99.1, R100.1, U3.4 (GND), U8.2 (GND), Z2.2 (A); also elsewhere on the board
GND: C41.2, C42.2, U3.3 (C); also elsewhere on the board
unnamed: C62.2, R96.2
unnamed: C63.1, D9.1, R99.2
unnamed: C63.2, R100.2
unnamed: R40.2, U3.1 (A)
unnamed: R28.2, R97.1, U3.5 (VO)
unnamed: R97.2, U8.3 (IN+)
unnamed: R98.2, U8.1 (IN-)

Notes on the sheet:
Gate snubber.
Note: 1. MOSFET V_DS >= 100 V, V_GS >= 20 V 2. Drain snubber section is to be populated only if the switch has no local snubber.
Drain snubber.

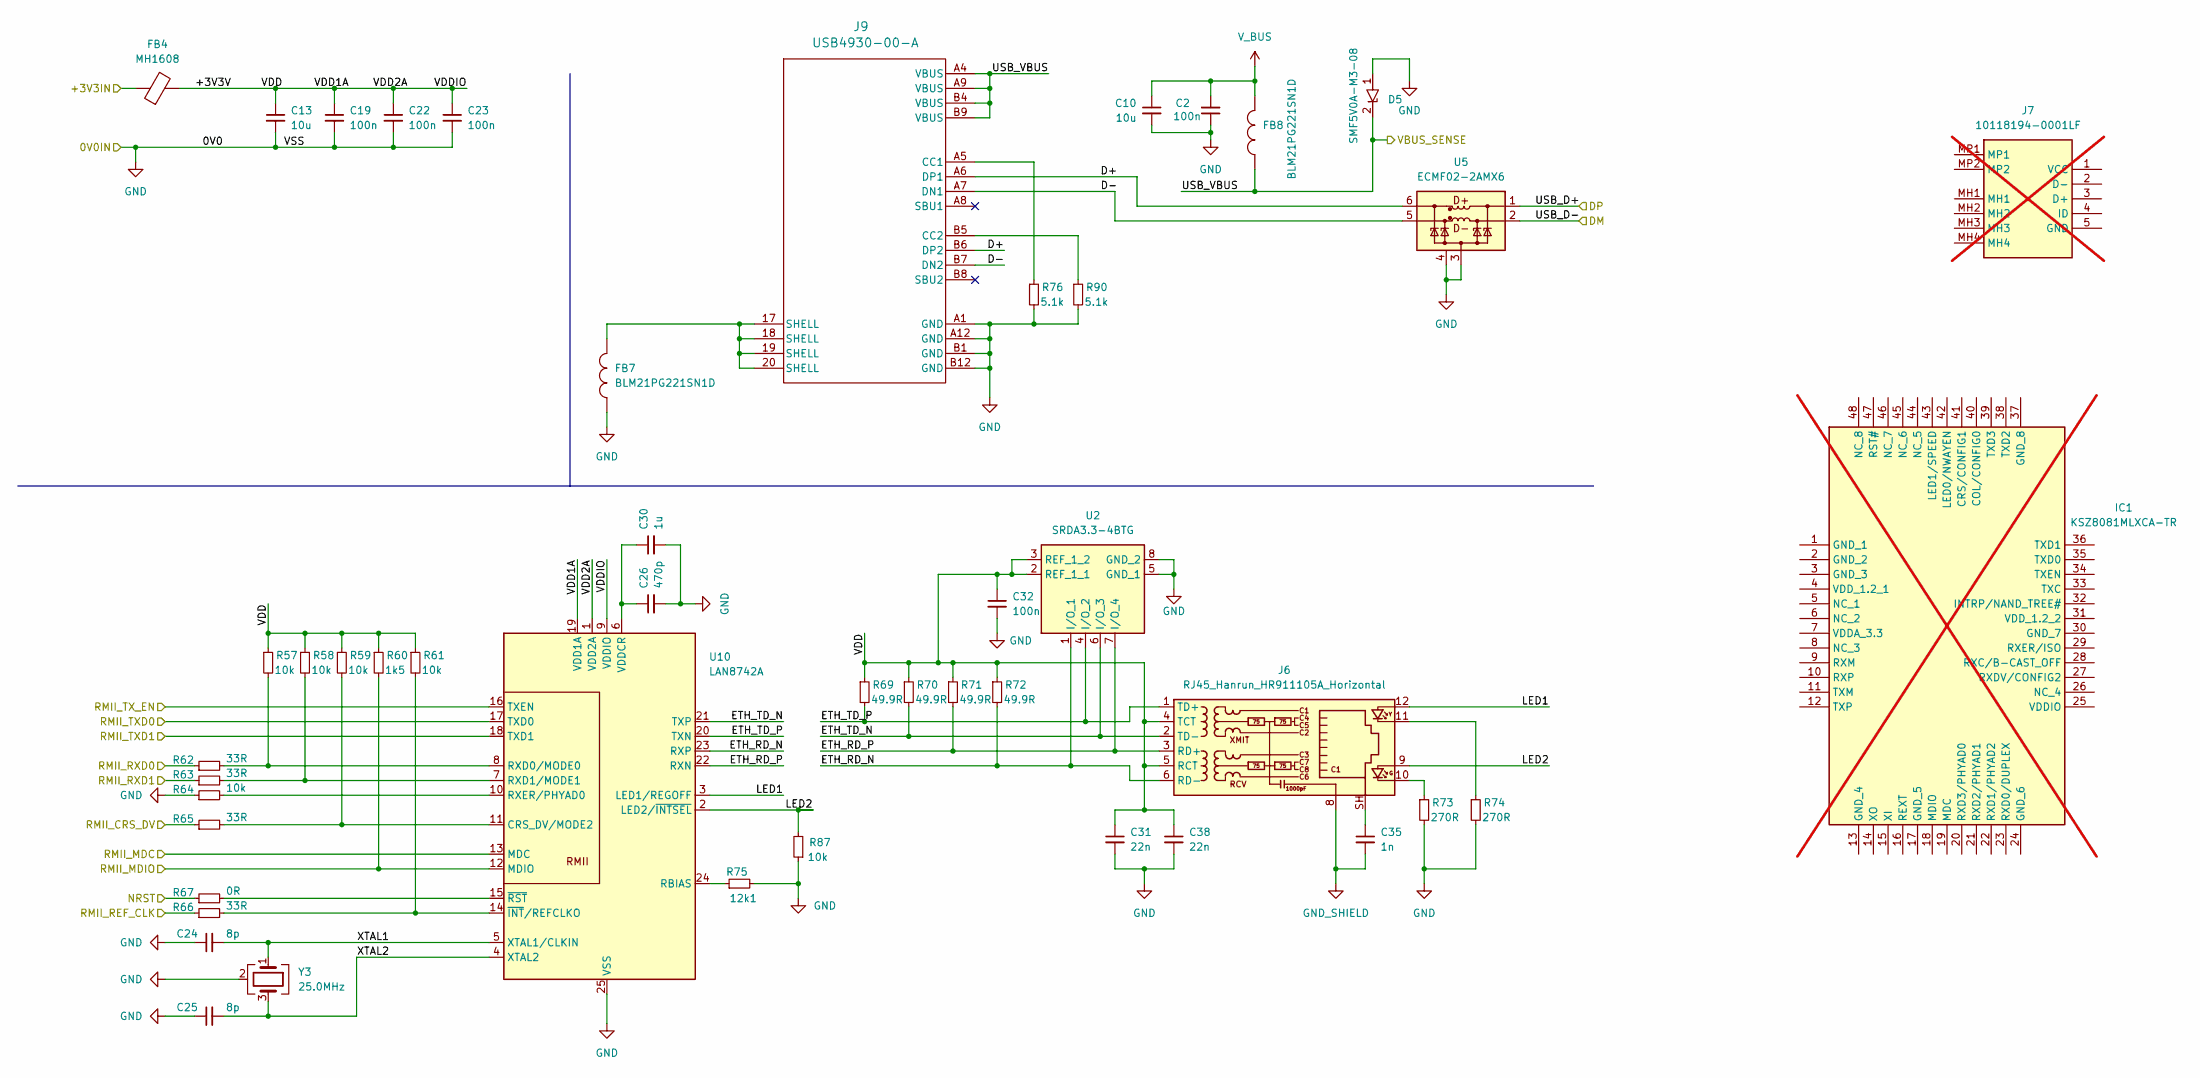
[picture p14: schematic communication.kicad_sch, Nano stage controller]

Parts:
C2, C19, C22, C23, C32: 100n; C_0603_1608Metric; Voltage 16V
C10, C13: 10u; C_1206_3216Metric; Voltage 16V
C24, C25: 8p; C_0603_1608Metric; Voltage 16V
C26: 470p; C_0603_1608Metric; Voltage 16V
C30: 1u; C_0603_1608Metric; Voltage 16V
C31, C38: 22n; C_0603_1608Metric; Voltage 50V; Tolerence 10%
C35: 1n; C_0603_1608Metric; Voltage 50V
D5: SMF5V0A-M3-08; D_SMF
FB4: MH1608; L_0603_1608Metric
FB7, FB8: BLM21PG221SN1D; L_0805_2012Metric
IC1: KSZ8081MLXCA-TR; QFP50P900X900X160-48N; not fitted
J6: RJ45_Hanrun_HR911105A_Horizontal
J7: 10118194-0001LF; 101181940001LF; not fitted
J9: USB4930-00-A
R57, R58, R59, R61, R64, R87: 10k; R_0603_1608Metric
R60: 1k5; R_0603_1608Metric
R62, R63, R65, R66: 33R; R_0603_1608Metric
R67: 0R; R_0603_1608Metric
R69, R70, R71, R72: 49.9R; R_0603_1608Metric
R73, R74: 270R; R_0603_1608Metric
R75: 12k1; R_0603_1608Metric
R76, R90: 5.1k; R_0603_1608Metric
U2: SRDA3.3-4BTG; SOIC-8_3.9x4.9mm_P1.27mm
U5: ECMF02-2AMX6; ST_UQFN-6L_1.5x1.7mm_P0.5mm
U10: LAN8742A; VQFN-24-1EP_4x4mm_P0.5mm_EP2.5x2.5mm_ThermalVias
Y3: 25.0MHz; Crystal_SMD_3225-4Pin_3.2x2.5mm_HandSoldering

Connections:
/Block Diagram/+3V3: FB4.1; also elsewhere on the board
/Block Diagram/Communication/+3V3V: C13.1, C19.1, C22.1, C23.1, C31.1, C32.1, C38.1, FB4.2, J6.4 (TCT), J6.5 (RCT), R57.1, R58.1, R59.1, R60.1, R61.1, R69.1, R70.1, R71.1, R72.1, U2.2 (REF_1_1), U2.3 (REF_1_2), U10.1 (VDD2A), U10.9 (VDDIO), U10.19 (VDD1A)
/Block Diagram/Communication/D+: J9.A6 (DP1), J9.B6 (DP2), U5.6 (D+_out)
/Block Diagram/Communication/D-: J9.A7 (DN1), J9.B7 (DN2), U5.5 (D-_out)
/Block Diagram/Communication/ETH_RD_N: J6.6 (RD-), R72.2, U2.1 (I/O_1), U10.23 (RXP)
/Block Diagram/Communication/ETH_RD_P: J6.3 (RD+), R71.2, U2.7 (I/O_4), U10.22 (RXN)
/Block Diagram/Communication/ETH_TD_N: J6.2 (TD-), R70.2, U2.6 (I/O_3), U10.21 (TXP)
/Block Diagram/Communication/ETH_TD_P: J6.1 (TD+), R69.2, U2.4 (I/O_2), U10.20 (TXN)
/Block Diagram/Communication/LED1: J6.12, U10.3 (LED1/REGOFF)
/Block Diagram/Communication/LED2: J6.9, R87.2, U10.2 (LED2/~INTSEL)
/Block Diagram/Communication/RMII_CRS_DV: R65.1; also elsewhere on the board
/Block Diagram/Communication/RMII_MDC: U10.13 (MDC); also elsewhere on the board
/Block Diagram/Communication/RMII_MDIO: R60.2, U10.12 (MDIO); also elsewhere on the board
/Block Diagram/Communication/RMII_REF_CLK: R66.1; also elsewhere on the board
/Block Diagram/Communication/RMII_RXD0: R62.1; also elsewhere on the board
/Block Diagram/Communication/RMII_RXD1: R63.1; also elsewhere on the board
/Block Diagram/Communication/RMII_TXD0: U10.17 (TXD0); also elsewhere on the board
/Block Diagram/Communication/RMII_TXD1: U10.18 (TXD1); also elsewhere on the board
/Block Diagram/Communication/RMII_TX_EN: U10.16 (TXEN); also elsewhere on the board
/Block Diagram/Communication/USB_D+: U5.1 (D+_in); also elsewhere on the board
/Block Diagram/Communication/USB_D-: U5.2 (D-_in); also elsewhere on the board
/Block Diagram/Communication/USB_VBUS: D5.2 (C), FB8.1, J9.A4 (VBUS), J9.A9 (VBUS), J9.B4 (VBUS), J9.B9 (VBUS); also elsewhere on the board
/Block Diagram/Communication/XTAL1: C24.2, U10.5 (XTAL1/CLKIN), Y3.1
/Block Diagram/Communication/XTAL2: C25.2, U10.4 (XTAL2), Y3.3
/Block Diagram/Controller/NRST: R67.1; also elsewhere on the board
GND: C2.1, C10.2, C13.2, C19.2, C22.2, C23.2, C24.1, C25.1, C26.2, C30.2, C31.2, C32.2, C38.2, D5.1 (A), FB7.1, J9.A1 (GND), J9.A12 (GND), J9.B1 (GND), J9.B12 (GND), R64.1, R73.2, R74.2, R75.2, R76.2, R87.1, R90.2, U2.5 (GND_1), U2.8 (GND_2), U5.3 (GND), U5.4 (NC), U10.25 (VSS), Y3.2 (G), Y3.4 (G); also elsewhere on the board
GND_SHIELD: C35.2, J6.8
unnamed: C35.1, J6.SH
unnamed: FB7.2, J9.17 (SHELL), J9.18 (SHELL), J9.19 (SHELL), J9.20 (SHELL)
unnamed: J6.10, R73.1
unnamed: J6.11, R74.1
unnamed: J9.A5 (CC1), R76.1
unnamed: J9.B5 (CC2), R90.1
unnamed: R59.2, R65.2, U10.11 (CRS_DV/MODE2)
unnamed: R75.1, U10.24 (RBIAS)
unnamed: R57.2, R62.2, U10.8 (RXD0/MODE0)
unnamed: R58.2, R63.2, U10.7 (RXD1/MODE1)
unnamed: R64.2, U10.10 (RXER/PHYAD0)
unnamed: C26.1, C30.1, U10.6 (VDDCR)
unnamed: R61.2, R66.2, U10.14 (~INT/REFCLKO)
unnamed: R67.2, U10.15 (~RST)
V_BUS: C2.2, C10.1, FB8.2; also elsewhere on the board

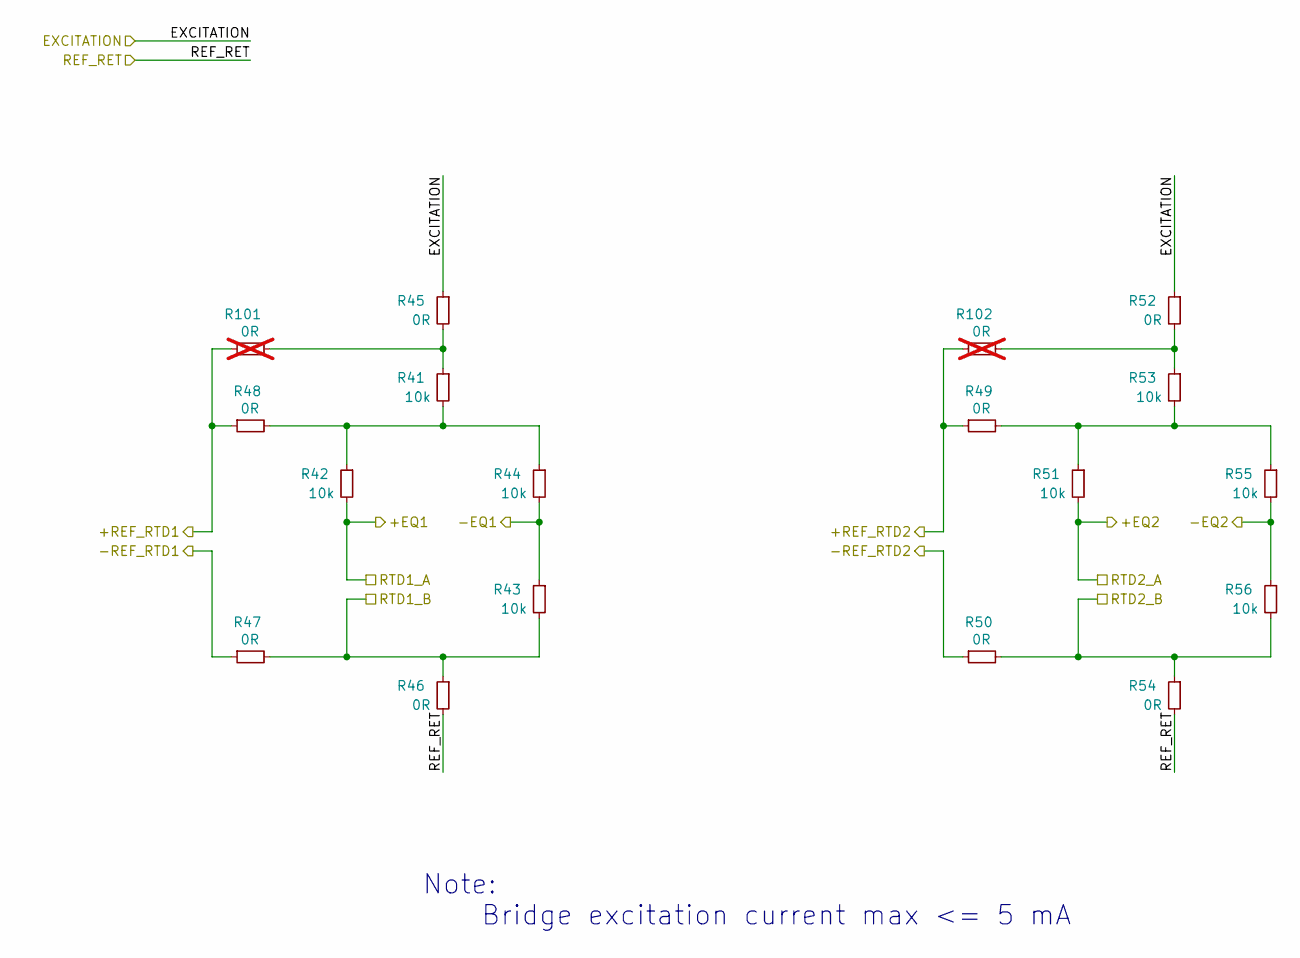
[picture p15: schematic interface.kicad_sch, Nano stage controller]

Parts:
R41, R42, R43, R44, R51, R53, R55, R56: 10k; R_0805_2012Metric_Pad1.20x1.40mm_HandSolder
R45, R46, R47, R48, R49, R50, R52, R54: 0R; R_0805_2012Metric_Pad1.20x1.40mm_HandSolder
R101, R102: 0R; R_0805_2012Metric_Pad1.20x1.40mm_HandSolder; not fitted

Connections:
/Block Diagram/ADC/+A0: R42.2; also elsewhere on the board
/Block Diagram/ADC/+A1: R51.2; also elsewhere on the board
/Block Diagram/ADC/+REF_RTD1: R48.1, R101.1; also elsewhere on the board
/Block Diagram/ADC/+REF_RTD2: R49.1, R102.1; also elsewhere on the board
/Block Diagram/ADC/-A0: R43.1, R44.2; also elsewhere on the board
/Block Diagram/ADC/-A1: R55.2, R56.1; also elsewhere on the board
/Block Diagram/ADC/-REF_RTD1: R47.1, R50.1; also elsewhere on the board
/Block Diagram/Interface/EXCITATION: R45.1, R52.1; also elsewhere on the board
/Block Diagram/Interface/RTD1_B: R43.2, R46.1, R47.2; also elsewhere on the board
/Block Diagram/Interface/RTD2_B: R50.2, R54.1, R56.2; also elsewhere on the board
GND: R46.2, R54.2; also elsewhere on the board
unnamed: R41.2, R42.1, R44.1, R48.2
unnamed: R49.2, R51.1, R53.2, R55.1
unnamed: R41.1, R45.2, R101.2
unnamed: R52.2, R53.1, R102.2

Notes on the sheet:
Note: Bridge excitation current max <= 5 mA

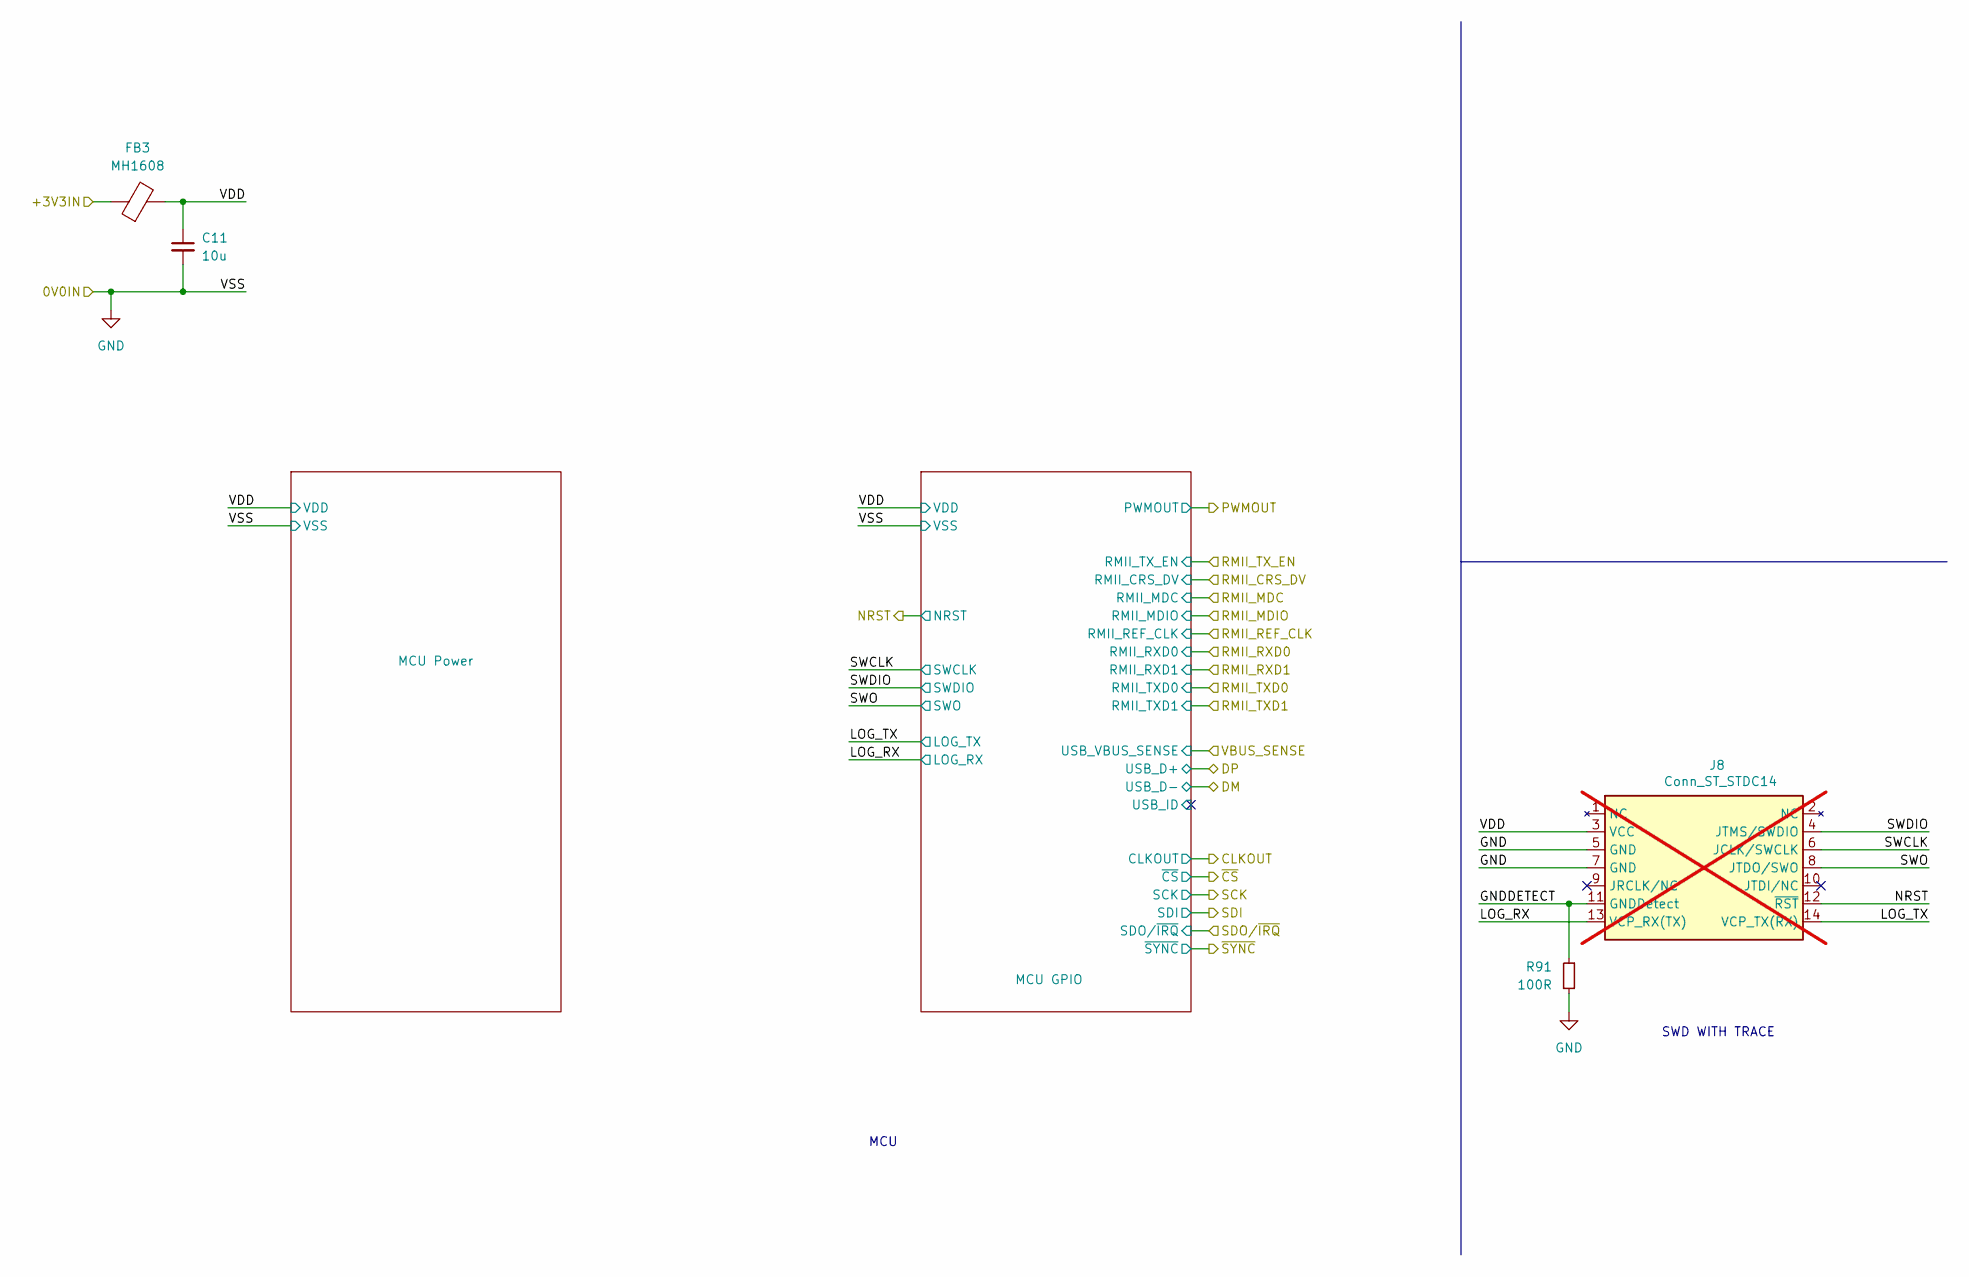
[picture p16: schematic controller.kicad_sch, Nano stage controller]

Parts:
C11: 10u; C_1206_3216Metric; Voltage 16V
FB3: MH1608; L_0603_1608Metric
J8: Conn_ST_STDC14; PinHeader_2x07_P1.27mm_Vertical; not fitted
R91: 100R; R_0603_1608Metric

Connections:
/Block Diagram/+3V3: FB3.1; also elsewhere on the board
/Block Diagram/Controller/GNDDETECT: J8.11 (GNDDetect), R91.1
/Block Diagram/Controller/LOG_RX: J8.13 (VCP_RX(TX)); also elsewhere on the board
/Block Diagram/Controller/LOG_TX: J8.14 (VCP_TX(RX)); also elsewhere on the board
/Block Diagram/Controller/NRST: J8.12 (~RST); also elsewhere on the board
/Block Diagram/Controller/SWCLK: J8.6 (JCLK/SWCLK); also elsewhere on the board
/Block Diagram/Controller/SWDIO: J8.4 (JTMS/SWDIO); also elsewhere on the board
/Block Diagram/Controller/SWO: J8.8 (JTDO/SWO); also elsewhere on the board
/Block Diagram/Controller/VDD: C11.1, FB3.2, J8.3 (VCC); also elsewhere on the board
GND: C11.2, J8.5 (GND), J8.7 (GND), R91.2; also elsewhere on the board

Notes on the sheet:
MCU
SWD WITH TRACE

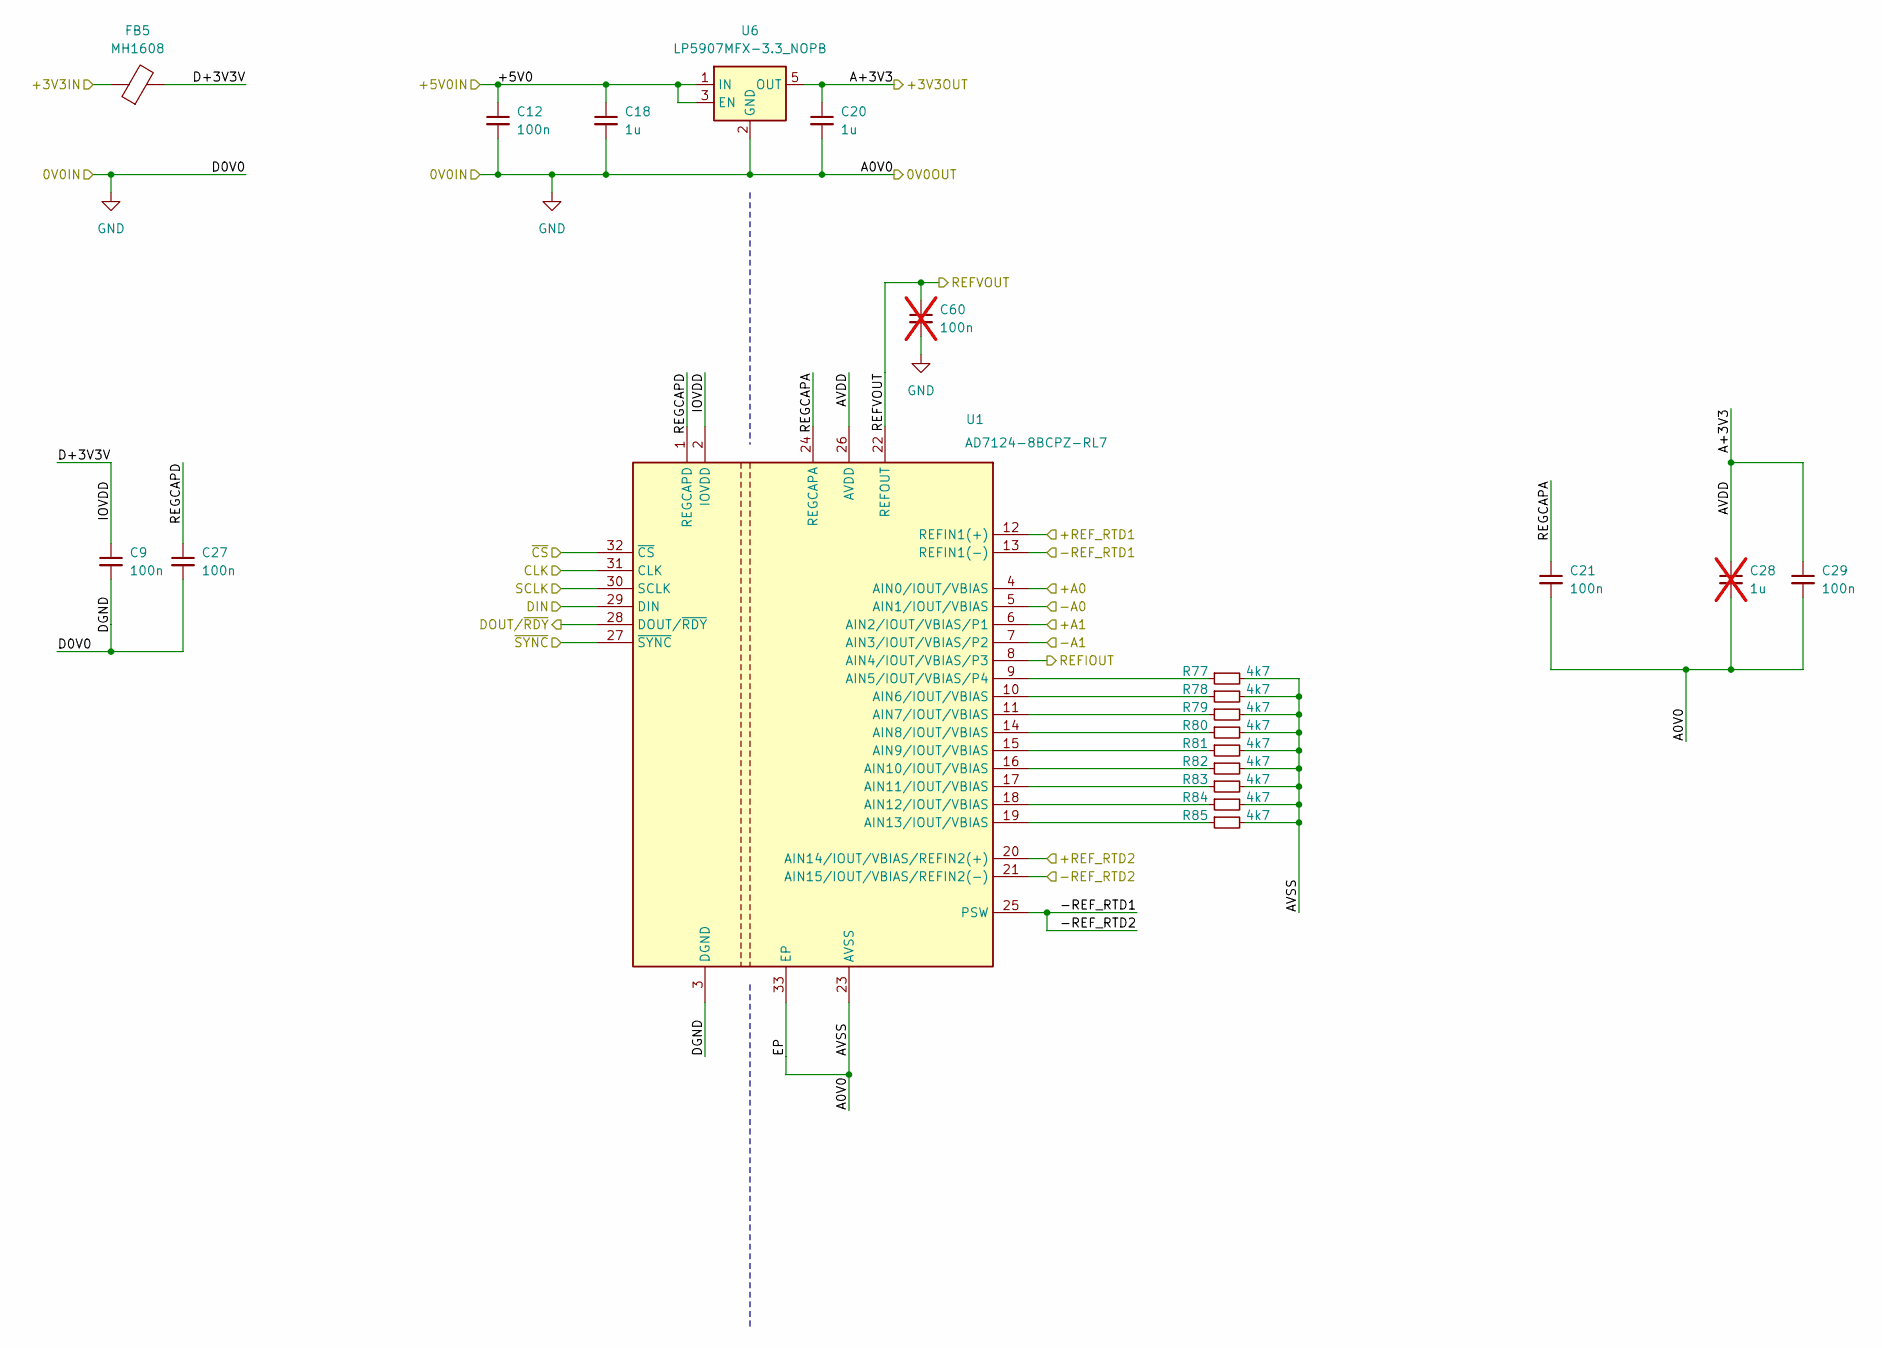
[picture p17: schematic adc.kicad_sch, Nano stage controller]

Parts:
C9, C12, C21, C27, C29: 100n; C_0603_1608Metric; Voltage 16V
C18, C20: 1u; C_0603_1608Metric; Voltage 16V
C28: 1u; C_0603_1608Metric; Voltage 16V; Tolerence 10%; not fitted
C60: 100n; C_0603_1608Metric; Voltage 16V; not fitted
FB5: MH1608; L_0603_1608Metric
R77, R78, R79, R80, R81, R82, R83, R84, R85: 4k7; R_0603_1608Metric
U1: AD7124-8BCPZ-RL7; QFN50P500X500X80-33N-D
U6: LP5907MFX-3.3_NOPB; SOT95P280X145-5N

Connections:
/Block Diagram/+3V3: FB5.1; also elsewhere on the board
/Block Diagram/+5V0: C12.1, C18.1, U6.1 (IN), U6.3 (EN); also elsewhere on the board
/Block Diagram/ADC/+A0: U1.4 (AIN0/IOUT/VBIAS); also elsewhere on the board
/Block Diagram/ADC/+A1: U1.6 (AIN2/IOUT/VBIAS/P1); also elsewhere on the board
/Block Diagram/ADC/+REF_RTD1: U1.12 (REFIN1(+)); also elsewhere on the board
/Block Diagram/ADC/+REF_RTD2: U1.20 (AIN14/IOUT/VBIAS/REFIN2(+)); also elsewhere on the board
/Block Diagram/ADC/-A0: U1.5 (AIN1/IOUT/VBIAS); also elsewhere on the board
/Block Diagram/ADC/-A1: U1.7 (AIN3/IOUT/VBIAS/P2); also elsewhere on the board
/Block Diagram/ADC/-REF_RTD1: U1.13 (REFIN1(-)), U1.21 (AIN15/IOUT/VBIAS/REFIN2(-)), U1.25 (PSW); also elsewhere on the board
/Block Diagram/ADC/A+3V3: C20.1, C28.1, C29.1, U1.26 (AVDD), U6.5 (OUT); also elsewhere on the board
/Block Diagram/ADC/CLK: U1.31 (CLK); also elsewhere on the board
/Block Diagram/ADC/D+3V3V: C9.1, FB5.2, U1.2 (IOVDD)
/Block Diagram/ADC/DIN: U1.29 (DIN); also elsewhere on the board
/Block Diagram/ADC/DOUT/~RDY: U1.28 (DOUT/~RDY); also elsewhere on the board
/Block Diagram/ADC/REFIOUT: U1.8 (AIN4/IOUT/VBIAS/P3); also elsewhere on the board
/Block Diagram/ADC/REFVOUT: C60.1, U1.22 (REFOUT); also elsewhere on the board
/Block Diagram/ADC/REGCAPA: C21.1, U1.24 (REGCAPA)
/Block Diagram/ADC/REGCAPD: C27.1, U1.1 (REGCAPD)
/Block Diagram/ADC/SCLK: U1.30 (SCLK); also elsewhere on the board
/Block Diagram/ADC/~CS: U1.32 (~CS); also elsewhere on the board
/Block Diagram/ADC/~SYNC: U1.27 (~SYNC); also elsewhere on the board
GND: C9.2, C12.2, C18.2, C20.2, C21.2, C27.2, C28.2, C29.2, C60.2, R77.2, R78.2, R79.2, R80.2, R81.2, R82.2, R83.2, R84.2, R85.2, U1.3 (DGND), U1.23 (AVSS), U1.33 (EP), U6.2 (GND); also elsewhere on the board
unnamed: R77.1, U1.9 (AIN5/IOUT/VBIAS/P4)
unnamed: R78.1, U1.10 (AIN6/IOUT/VBIAS)
unnamed: R79.1, U1.11 (AIN7/IOUT/VBIAS)
unnamed: R80.1, U1.14 (AIN8/IOUT/VBIAS)
unnamed: R81.1, U1.15 (AIN9/IOUT/VBIAS)
unnamed: R82.1, U1.16 (AIN10/IOUT/VBIAS)
unnamed: R83.1, U1.17 (AIN11/IOUT/VBIAS)
unnamed: R84.1, U1.18 (AIN12/IOUT/VBIAS)
unnamed: R85.1, U1.19 (AIN13/IOUT/VBIAS)
