er-shubhendu-ee/cryonano-nano-stage/cryonano-nano-stage/cryonano-nano-stage.kicad_pcb

## KiCad design cryonano-nano-stage/cryonano-nano-stage.kicad_pcb (continued)

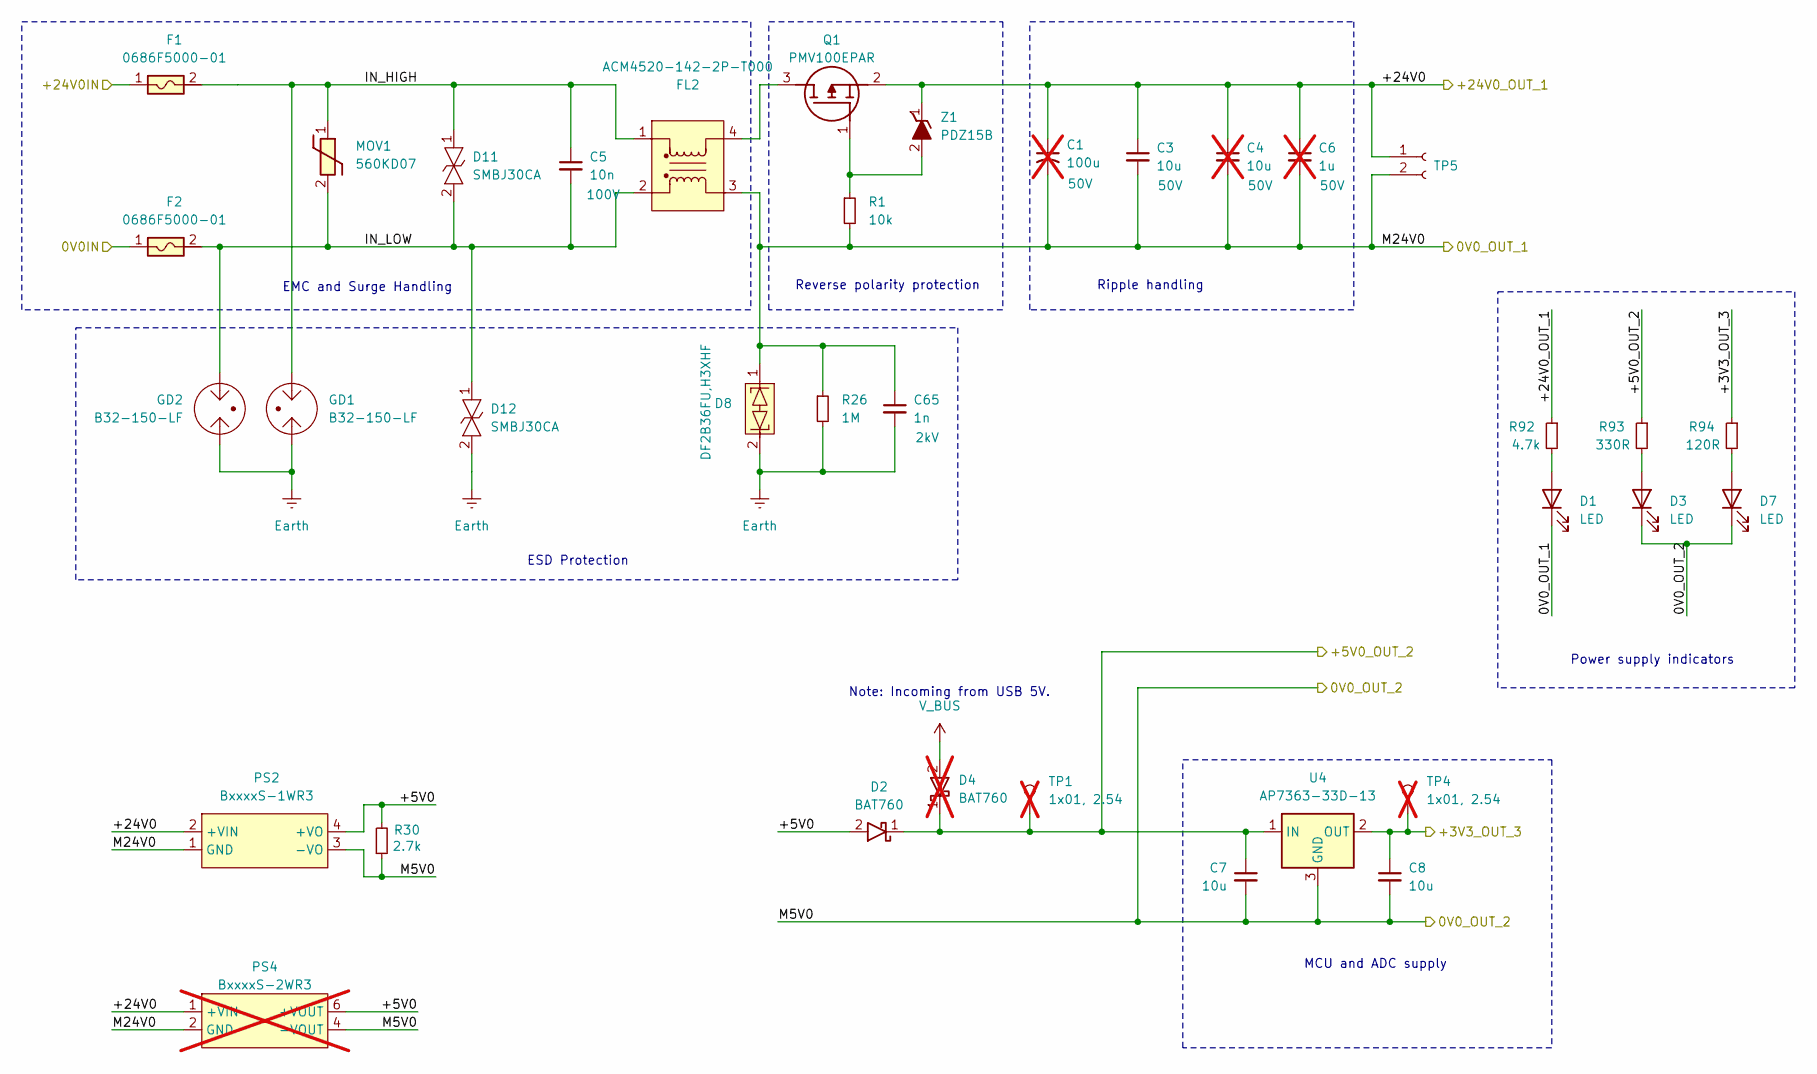
[picture p18: schematic power.kicad_sch, Nano stage controller]

Parts:
C1: 100u; CP_Radial_D8.0mm_P3.50mm; Voltage 50V; not fitted
C3: 10u; C_1210_3225Metric; Voltage 50V
C4: 10u; C_1210_3225Metric; Voltage 50V; not fitted
C5: 10n; C_1206_3216Metric; Voltage 100V
C6: 1u; C_0805_2012Metric; Voltage 50V; not fitted
C7, C8: 10u; C_1206_3216Metric; Voltage 16V
C65: 1n; C_Disc_D9.0mm_W5.0mm_P7.50mm; Voltage 2kV
D1, D3, D7: LED; LED_0603_1608Metric_Pad1.05x0.95mm_HandSolder
D2: BAT760; D_SOD-323; Voltage 30V
D4: BAT760; D_SOD-323; not fitted
D8: DF2B36FU,H3XHF; D_SOD-323
D11, D12: SMBJ30CA; D_SMB; Voltage 30V
F1, F2: 0686F5000-01; Fuse_0603_1608Metric
FL2: ACM4520-142-2P-T000; ACM45204212PT000
GD1, GD2: B32-150-LF; B32_GDT_YAGEO
MOV1: 560KD07; RV_Disc_D9mm_W4.8mm_P5mm
PS2: BxxxxS-1WR3
PS4: BxxxxS-2WR3; not fitted
Q1: PMV100EPAR; SOT95P230X110-3N
R1: 10k; R_0603_1608Metric
R26: 1M; R_Axial_DIN0207_L6.3mm_D2.5mm_P10.16mm_Horizontal
R30: 2.7k; R_0805_2012Metric
R92: 4.7k; R_0603_1608Metric
R93: 330R; R_0603_1608Metric
R94: 120R; R_0603_1608Metric
TP1, TP4: 1x01, 2.54; TestPoint_THTPad_D1.3mm_Drill0.8mm; not fitted
TP5: 1x02, 2.54; PinSocket_1x02_P2.54mm_Vertical
U4: AP7363-33D-13; TO252__DPAK__1
Z1: PDZ15B; SOD2512X110N

Connections:
/Block Diagram/+3V3: C8.1, R94.1, TP4.1 (1_1), U4.2 (OUT); also elsewhere on the board
/Block Diagram/+5V0: C7.1, D2.1 (K), D4.1 (K), R93.1, TP1.1 (1_1), U4.1 (IN); also elsewhere on the board
/Block Diagram/+24V0: C1.1, C3.1, C4.1, C6.1, PS2.2 (+VIN), PS4.1 (+VIN), Q1.2 (S), R92.1, TP5.1, Z1.1 (K); also elsewhere on the board
/Block Diagram/M24V0: C1.2, C3.2, C4.2, C6.2, C65.1, D1.1 (K), D8.1, FL2.3, PS2.1 (GND), PS4.2 (GND), R1.2, R26.1, TP5.2; also elsewhere on the board
/Block Diagram/Power/0V0IN: F2.1; also elsewhere on the board
/Block Diagram/Power/+5V0: D2.2 (A), PS2.4 (+VO), PS4.6 (+VOUT), R30.2
/Block Diagram/Power/+24V0IN: F1.1; also elsewhere on the board
/Block Diagram/Power/IN_HIGH: C5.1, D11.1, F1.2, FL2.1, GD1.1, MOV1.1
/Block Diagram/Power/IN_LOW: C5.2, D11.2, D12.1, F2.2, FL2.2, GD2.1, MOV1.2
Earth: C65.2, D8.2, D12.2, GD1.2, GD2.2, R26.2; also elsewhere on the board
GND: C7.2, C8.2, D3.1 (K), D7.1 (K), PS2.3 (-VO), PS4.4 (-VOUT), R30.1, U4.3 (GND); also elsewhere on the board
unnamed: D1.2 (A), R92.2
unnamed: D3.2 (A), R93.2
unnamed: D7.2 (A), R94.2
unnamed: FL2.4, Q1.3 (D)
unnamed: Q1.1 (G), R1.1, Z1.2 (A)
V_BUS: D4.2 (A); also elsewhere on the board

Notes on the sheet:
Power supply indicators
ESD Protection
EMC and Surge Handling
Reverse polarity protection
MCU and ADC supply
Ripple handling
Note: Incoming from USB 5V.

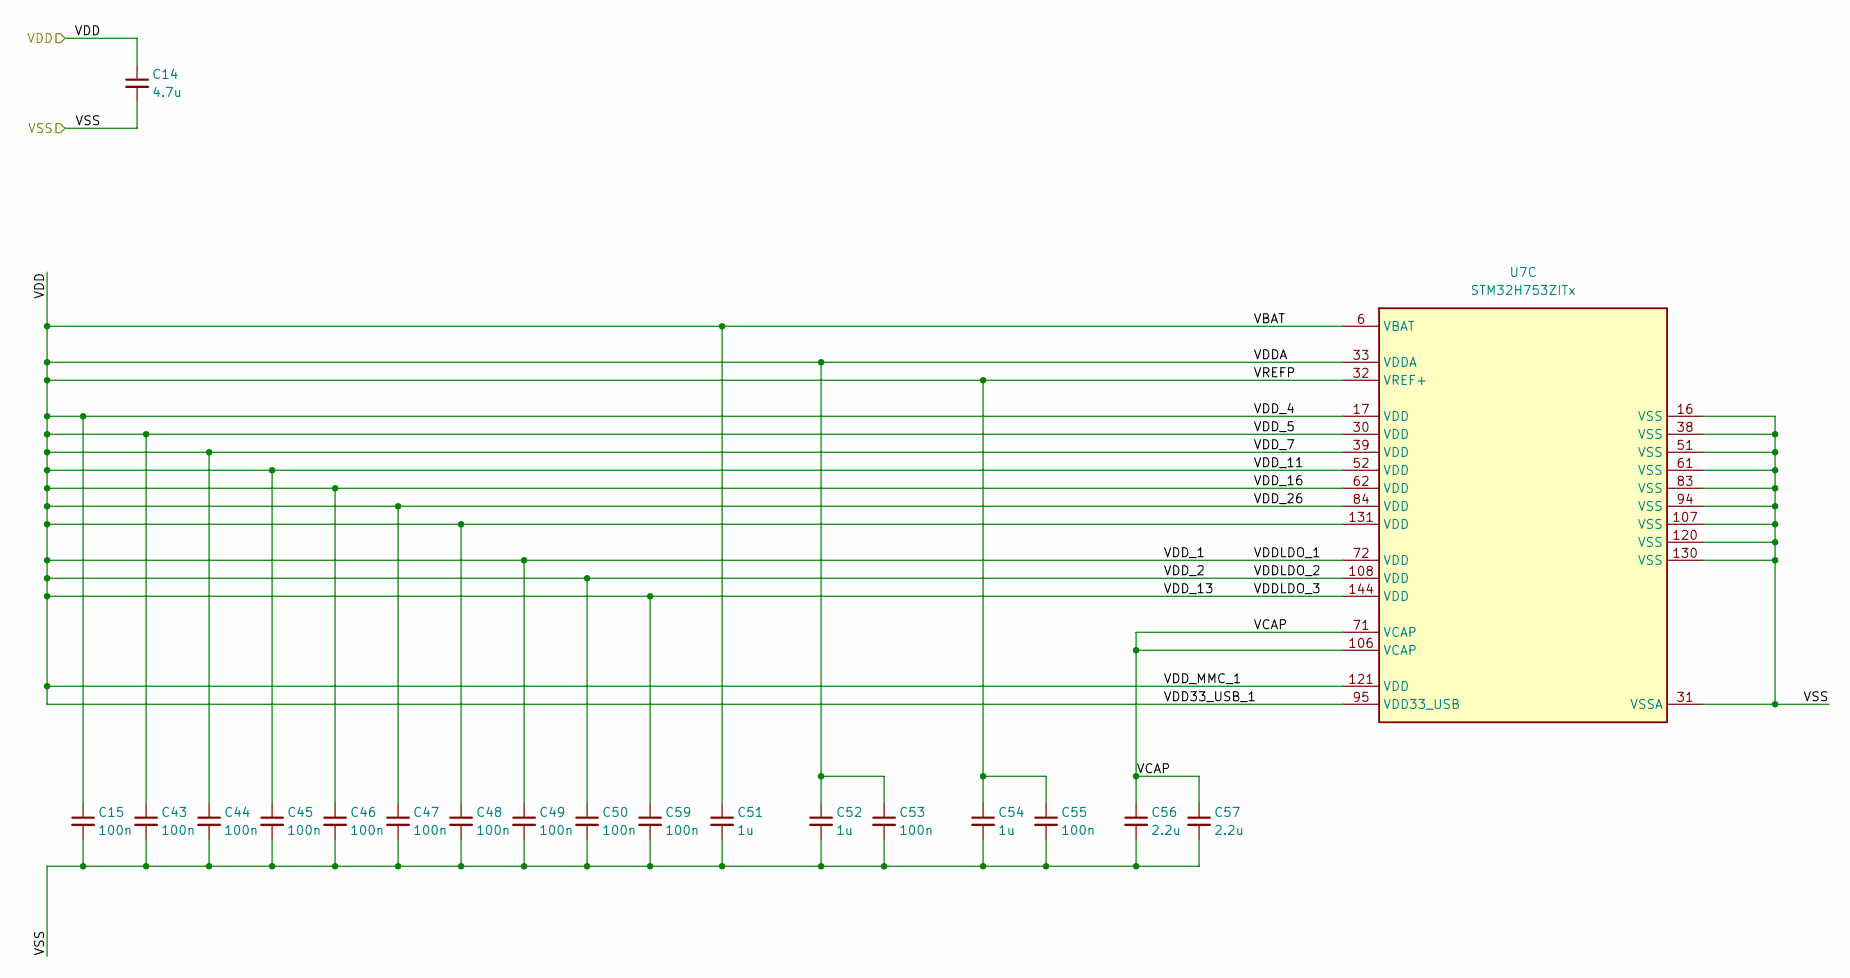
[picture p19: schematic mcu-power.kicad_sch, Nano stage controller]

Parts:
C14: 4.7u; C_0805_2012Metric; Voltage 16V; Tolerence 10%
C15, C43, C44, C45, C46, C47, C48, C49, C50, C53, C55, C59: 100n; C_0603_1608Metric; Voltage 16V
C51, C52, C54: 1u; C_0603_1608Metric; Voltage 16V; Tolerence 10%
C56, C57: 2.2u; C_0603_1608Metric; Voltage 16V; Tolerence 10%
U7: STM32H753ZITx; LQFP-144_20x20mm_P0.5mm

Connections:
/Block Diagram/Controller/MCU Power/VCAP: C56.1, C57.1, U7.71 (VCAP), U7.106 (VCAP)
/Block Diagram/Controller/VDD: C14.1, C15.1, C43.1, C44.1, C45.1, C46.1, C47.1, C48.1, C49.1, C50.1, C51.1, C52.1, C53.1, C54.1, C55.1, C59.1, U7.6 (VBAT), U7.17 (VDD), U7.30 (VDD), U7.32 (VREF+), U7.33 (VDDA), U7.39 (VDD), U7.52 (VDD), U7.62 (VDD), U7.72 (VDD), U7.84 (VDD), U7.95 (VDD33_USB), U7.108 (VDD), U7.121 (VDD), U7.131 (VDD), U7.144 (VDD); also elsewhere on the board
GND: C14.2, C15.2, C43.2, C44.2, C45.2, C46.2, C47.2, C48.2, C49.2, C50.2, C51.2, C52.2, C53.2, C54.2, C55.2, C56.2, C57.2, C59.2, U7.16 (VSS), U7.31 (VSSA), U7.38 (VSS), U7.51 (VSS), U7.61 (VSS), U7.83 (VSS), U7.94 (VSS), U7.107 (VSS), U7.120 (VSS), U7.130 (VSS); also elsewhere on the board

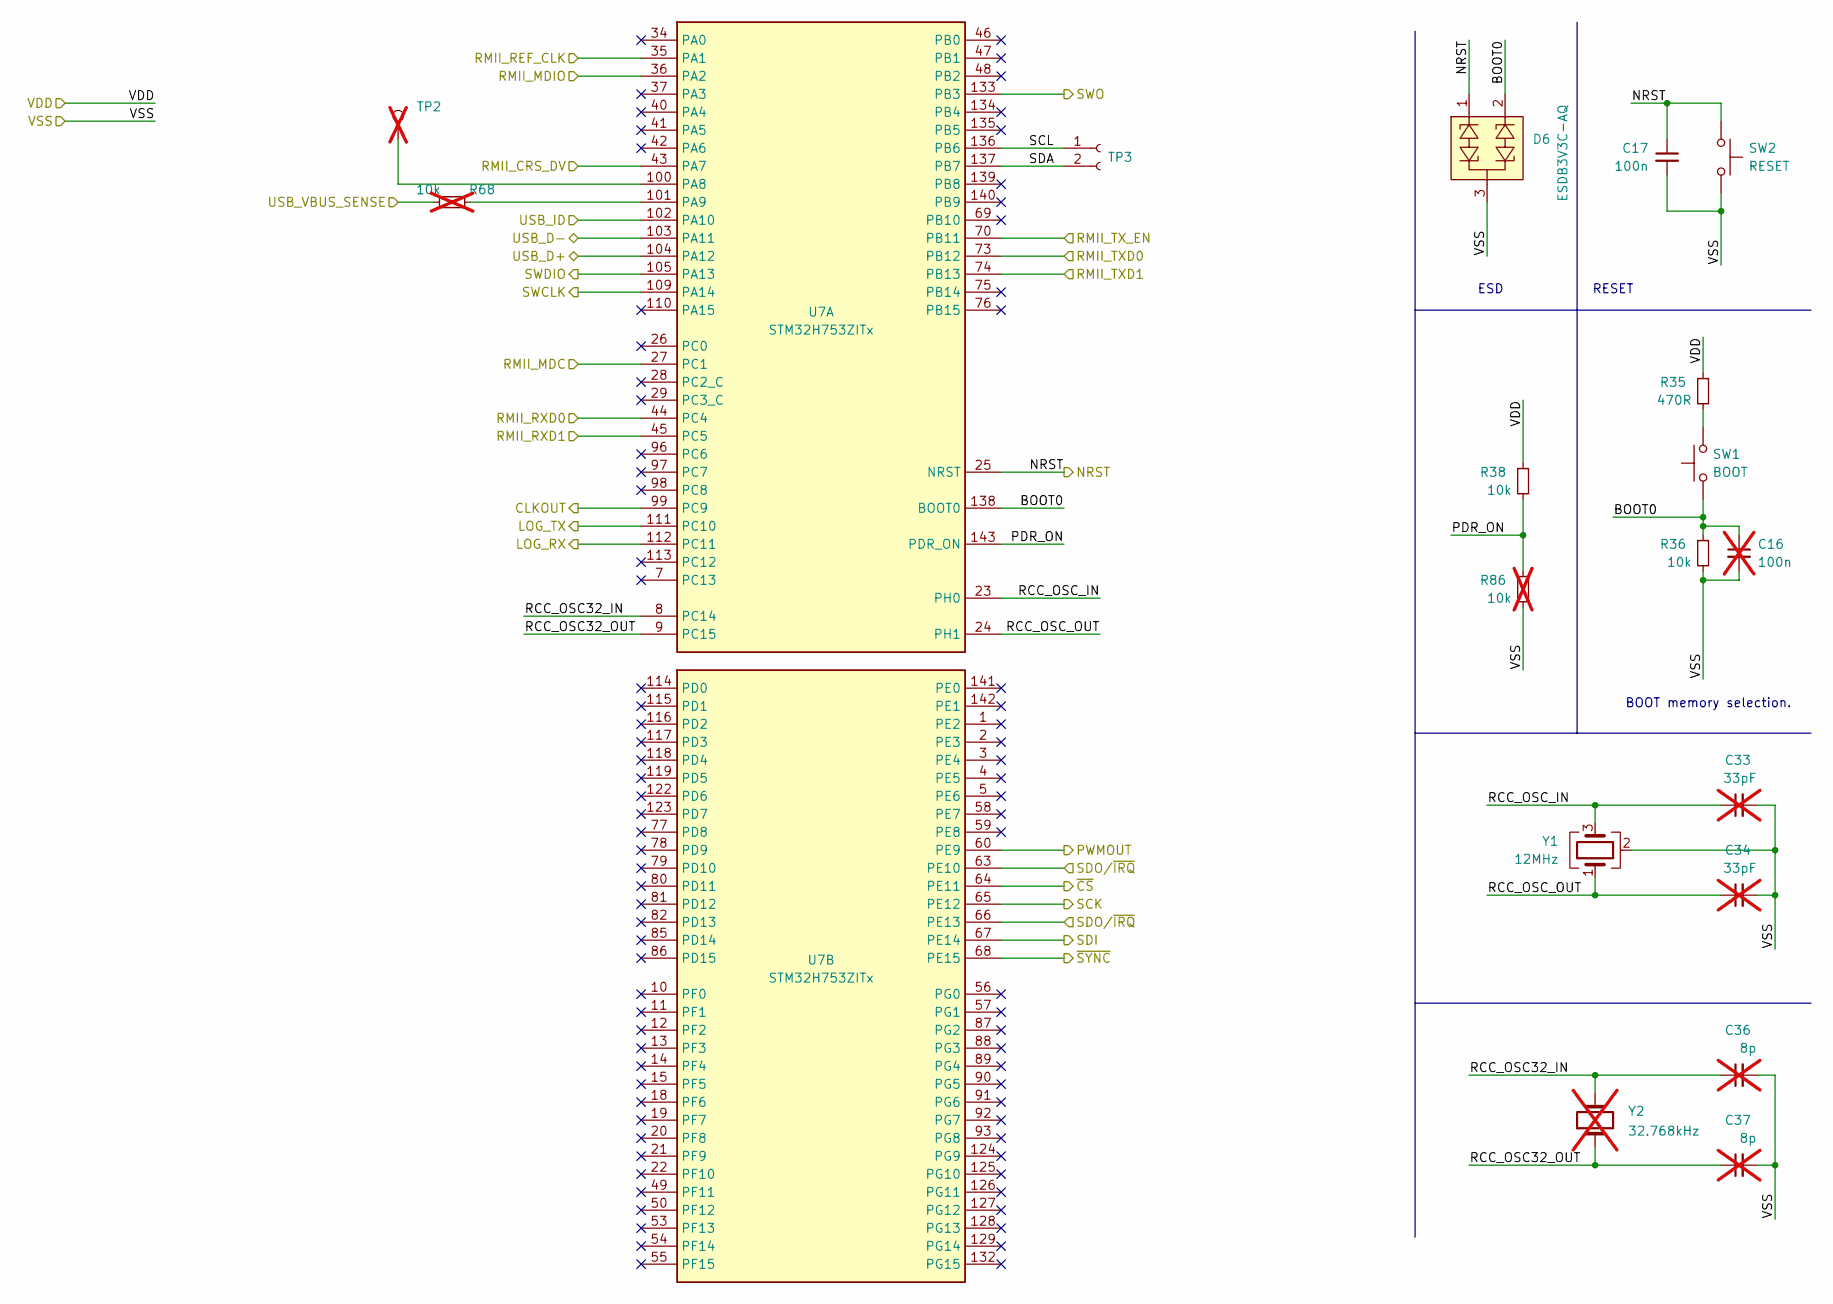
[picture p20: schematic mcu-gpio.kicad_sch, Nano stage controller]

Parts:
C16: 100n; C_0603_1608Metric; Voltage 16V; not fitted
C17: 100n; C_0603_1608Metric; Voltage 16V
C33, C34: 33pF; C_0603_1608Metric; Voltage 16V; not fitted
C36, C37: 8p; C_0603_1608Metric; Voltage 16V; not fitted
D6: ESDB3V3C-AQ; SOT-23
R35: 470R; R_0603_1608Metric
R36, R38: 10k; R_0603_1608Metric
R68, R86: 10k; R_0603_1608Metric; not fitted
SW1: BOOT; SW_PUSH_6mm
SW2: RESET; SW_PUSH_6mm
TP2: 1x01, 2.54; TestPoint_THTPad_D1.3mm_Drill0.8mm; not fitted
TP3: 1x02, 2.54; PinSocket_1x02_P2.54mm_Vertical
U7: STM32H753ZITx; LQFP-144_20x20mm_P0.5mm
Y1: 12MHz; Crystal_SMD_2520-4Pin_2.5x2.0mm
Y2: 32.768kHz; Crystal_SMD_3215-2Pin_3.2x1.5mm; not fitted

Connections:
/Block Diagram/ADC/CLK: U7.99 (PC9); also elsewhere on the board
/Block Diagram/ADC/DIN: U7.67 (PE14); also elsewhere on the board
/Block Diagram/ADC/DOUT/~RDY: U7.63 (PE10), U7.66 (PE13); also elsewhere on the board
/Block Diagram/ADC/SCLK: U7.65 (PE12); also elsewhere on the board
/Block Diagram/ADC/~CS: U7.64 (PE11); also elsewhere on the board
/Block Diagram/ADC/~SYNC: U7.68 (PE15); also elsewhere on the board
/Block Diagram/Communication/RMII_CRS_DV: U7.43 (PA7); also elsewhere on the board
/Block Diagram/Communication/RMII_MDC: U7.27 (PC1); also elsewhere on the board
/Block Diagram/Communication/RMII_MDIO: U7.36 (PA2); also elsewhere on the board
/Block Diagram/Communication/RMII_REF_CLK: U7.35 (PA1); also elsewhere on the board
/Block Diagram/Communication/RMII_RXD0: U7.44 (PC4); also elsewhere on the board
/Block Diagram/Communication/RMII_RXD1: U7.45 (PC5); also elsewhere on the board
/Block Diagram/Communication/RMII_TXD0: U7.73 (PB12); also elsewhere on the board
/Block Diagram/Communication/RMII_TXD1: U7.74 (PB13); also elsewhere on the board
/Block Diagram/Communication/RMII_TX_EN: U7.70 (PB11); also elsewhere on the board
/Block Diagram/Communication/USB_D+: U7.104 (PA12); also elsewhere on the board
/Block Diagram/Communication/USB_D-: U7.103 (PA11); also elsewhere on the board
/Block Diagram/Communication/USB_VBUS: R68.1; also elsewhere on the board
/Block Diagram/Controller/LOG_RX: U7.112 (PC11); also elsewhere on the board
/Block Diagram/Controller/LOG_TX: U7.111 (PC10); also elsewhere on the board
/Block Diagram/Controller/MCU GPIO/BOOT0: C16.1, D6.2 (SIG2), R36.1, SW1.1, U7.138 (BOOT0)
/Block Diagram/Controller/MCU GPIO/PDR_ON: R38.2, R86.1, U7.143 (PDR_ON)
/Block Diagram/Controller/MCU GPIO/RCC_OSC32_IN: C36.1, U7.8 (PC14), Y2.2
/Block Diagram/Controller/MCU GPIO/RCC_OSC32_OUT: C37.1, U7.9 (PC15), Y2.1
/Block Diagram/Controller/MCU GPIO/RCC_OSC_IN: C33.1, U7.23 (PH0), Y1.3
/Block Diagram/Controller/MCU GPIO/RCC_OSC_OUT: C34.1, U7.24 (PH1), Y1.1
/Block Diagram/Controller/MCU GPIO/SCL: TP3.1, U7.136 (PB6)
/Block Diagram/Controller/MCU GPIO/SDA: TP3.2, U7.137 (PB7)
/Block Diagram/Controller/MCU GPIO/USB_ID: U7.102 (PA10)
/Block Diagram/Controller/NRST: C17.1, D6.1 (SIG1), SW2.1, U7.25 (NRST); also elsewhere on the board
/Block Diagram/Controller/PWMOUT: U7.60 (PE9); also elsewhere on the board
/Block Diagram/Controller/SWCLK: U7.109 (PA14); also elsewhere on the board
/Block Diagram/Controller/SWDIO: U7.105 (PA13); also elsewhere on the board
/Block Diagram/Controller/SWO: U7.133 (PB3); also elsewhere on the board
/Block Diagram/Controller/VDD: R35.1, R38.1; also elsewhere on the board
GND: C16.2, C17.2, C33.2, C34.2, C36.2, C37.2, D6.3 (COM), R36.2, R86.2, SW2.2, Y1.2 (G), Y1.4 (G); also elsewhere on the board
unnamed: R35.2, SW1.2
unnamed: TP2.1 (1_1), U7.100 (PA8)
unnamed: R68.2, U7.101 (PA9)

Notes on the sheet:
ESD
RESET
BOOT memory selection.

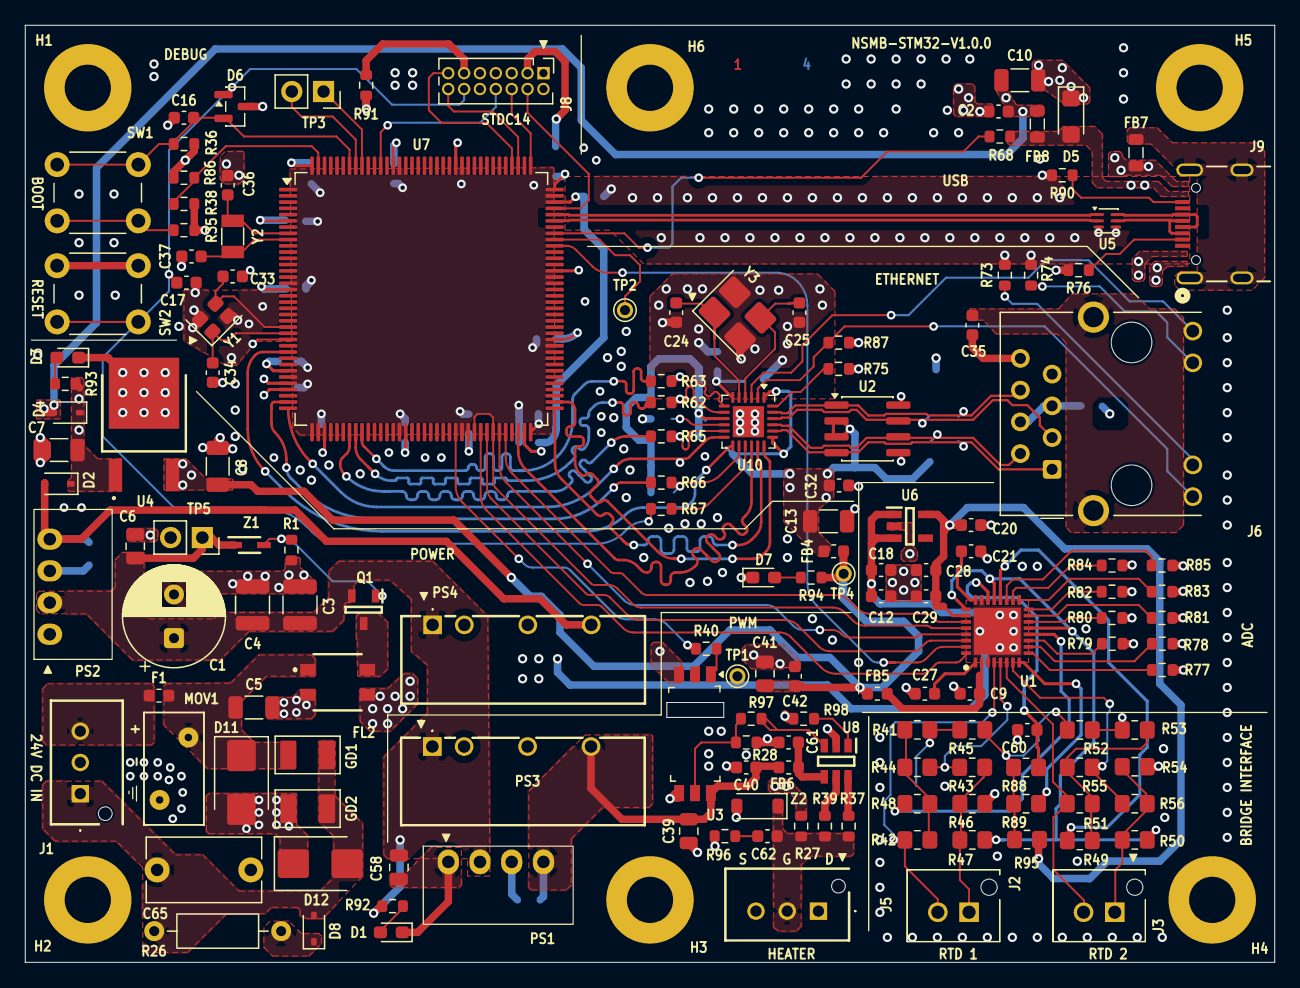
[picture p21: board cryonano-nano-stage.kicad_pcb from above]

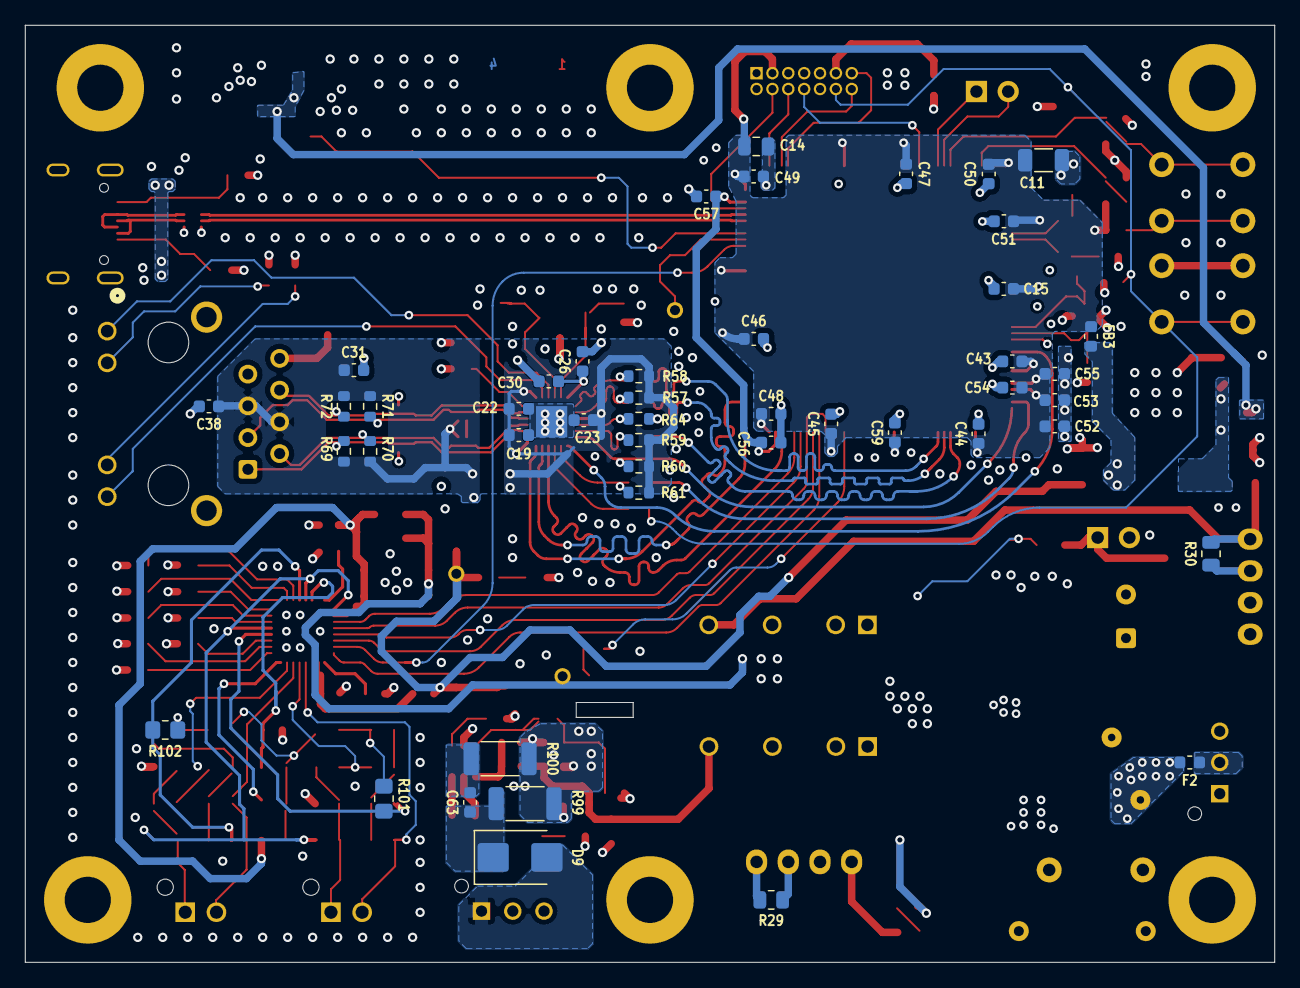
[picture p22: board cryonano-nano-stage.kicad_pcb from below]

Board: 4 copper layers, 100.0 x 75.0 mm, 200 parts (46 on the bottom side), 125 nets.
