er-shubhendu-ee/cryonano-nano-stage/(commit log)

2026-08-07 seperate template added for PCB
2026-08-10 few components listed
    [adc.kicad_sch, cryonano-nano-stage.kicad_sch, heater-controller.kicad_sch, high-side-n-mosfet-driver.kicad_sch, high-side-p-mosfet-driver.kicad_sch, interface.kicad_sch, mcu.kicad_sch, power.kicad_sch]
2026-08-11 preliminary components added
    [adc.kicad_sch, buck-converter-1.kicad_sch, buck-converter-2.kicad_sch, cryonano-nano-stage.kicad_pcb, cryonano-nano-stage.kicad_sch, display.kicad_sch, heater-controller.kicad_sch, isolation.kicad_sch]
2026-08-11 schematic cleaned
    [mcu.kicad_sch]
2026-08-11 sch updated
    [Proposed major components.xlsx, adc.kicad_sch, buck-converter-1.kicad_sch, buck-converter-2.kicad_sch, cryonano-nano-stage.kicad_pcb, cryonano-nano-stage.kicad_sch, high-side-n-mosfet-driver.kicad_sch, mcu.kicad_sch]
2026-08-11 partially populated
    [cryonano-nano-stage.kicad_pcb, cryonano-nano-stage.kicad_sch, usb.kicad_sch]
2026-08-13 sch improved
    [adc.kicad_sch, block-diagram.kicad_sch, buck-converter-1.kicad_sch, buck-converter-2.kicad_sch, communication.kicad_sch, controller.kicad_sch, cryonano-nano-stage.kicad_pcb, cryonano-nano-stage.kicad_sch]
2026-08-19 pcb drc ok. 68 ohm matching pending
    [adc.kicad_sch, block-diagram.kicad_sch, communication.kicad_sch, controller.kicad_sch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]
2026-08-20 drc no error, only warnings
    [block-diagram.kicad_sch, cryonano-nano-stage.kicad_pcb, interface.kicad_sch, mcu-gpio.kicad_sch, mcu-power.kicad_sch, power.kicad_sch]
2026-08-21 bom adjusted
    [adc.kicad_sch, block-diagram.kicad_sch, communication.kicad_sch, controller.kicad_sch, cryonano-nano-stage.kicad_pcb, heater-controller.kicad_sch, interface.kicad_sch, mcu-gpio.kicad_sch]
2026-08-24 drc ok, review schematic
    [adc.kicad_sch, block-diagram.kicad_sch, communication.kicad_sch, cryonano-nano-stage.kicad_pcb, heater-controller.kicad_sch, power.kicad_sch]
2026-08-25 drc ok. chip level review pending
    [block-diagram.kicad_sch, controller.kicad_sch, cryonano-nano-stage.kicad_pcb, heater-controller.kicad_sch, mcu-gpio.kicad_sch]
2026-08-26 sch reviewed
    [cryonano-nano-stage.kicad_pcb, heater-controller.kicad_sch, mcu-gpio.kicad_sch, power.kicad_sch]
2026-08-27 release candidate
    [adc.kicad_sch, block-diagram.kicad_sch, communication.kicad_sch, controller.kicad_sch, cryonano-nano-stage.kicad_pcb, heater-controller.kicad_sch, interface.kicad_sch, mcu-gpio.kicad_sch]
